Maestro8484/CyclopsGaze/docs/media/README.md

# Media

Photos and video of CyclopsGaze on the bench.

Drop image/video files here and reference them from the top-level [README.md](../../README.md)
and the docs.

**The hero shot is live** as of CG-S16: `CyclopsGaze-hero_photo.jpg`, a portrait close-up of the
`nordicBlue` eye with the SEN0626 camera mounted directly beneath it. The README renders it at a
constrained width because it is 1074x2114; a full-width portrait image is overwhelming on GitHub.
This replaces the never-existent `cyclopsgaze_tracking.jpg` that the README pointed at from
CG-S12 to CG-S16 and rendered as a broken image.

Video lives outside the repo on purpose. The 39-second demo clip and its Resolve project are in
`C:\Users\SuperMaster\Videos\CyclopsGaze\`, at 32 to 214 MB per render, which does not belong in
a git history everyone has to clone. Captions and platform copy for it are versioned here in
[VIDEO_CAPTIONS.md](VIDEO_CAPTIONS.md). If a clip is ever wanted in-repo, export a short
low-bitrate GIF or MP4 rather than committing a render.

Suggested shots still wanted:

- **Hero with a face in frame:** the assembled rig and a person, eye visibly looking toward them.
  The current hero is the rig alone.
- **Wiring:** a clear overhead of the wired breadboard/harness, matching the tables in
  [WIRING.md](../WIRING.md).
- **Serial:** a screenshot of the `[CG] faces=1 … -> tracking x=… y=…` serial output.
- **Dual-eye** (optional): both GC9A01A displays tracking together.
- **Detached camera module** (optional): the SEN0626 lens/ribbon separated from the Gravity board.

Keep files reasonably sized (long-edge ~1600 px for photos) so the repo stays lightweight. A short
tracking clip as a GIF or MP4 is welcome too.
