Maestro8484/CyclopsGaze/docs/SEN0626_PROTOCOL.md

# SEN0626 Protocol Reference

How CyclopsGaze talks to the DFRobot SEN0626 Gravity AI vision camera, and how its output
maps into the Useful Sensors Person Sensor struct. Driver source:
[`../src/sensors/SEN0626Sensor.cpp`](../src/sensors/SEN0626Sensor.cpp).

Primary vendor reference: DFRobot's `DFRobot_GestureFaceDetection` library and the SEN0626
wiki (`wiki.dfrobot.com/sen0626`). Everything below is cross-checked against that library and
confirmed on the bench except where marked assumed/unconfirmed.

## Transport

- **Protocol:** Modbus RTU over UART (not raw binary packets).
- **Device address:** `0x72`.
- **Baud:** `9600` factory default; `115200` also supported. The driver auto-detects: tries
  115200 then 9600, up to 3 full sweeps, after a 2s power-on settle (the sensor loads an AI
  model into RAM before it answers Modbus).
- **Wiring:** sensor on the Teensy's `Serial1`. Sensor TX → Teensy pin 0, sensor RX → Teensy
  pin 1. The breakout's I²C/UART DIP switch must be set to UART. (See [WIRING.md](WIRING.md).)

## Registers (FC04: read input registers)

| Reg | Meaning | Notes |
|----:|---|---|
| `0x00` | PID | expect `0x0272`, used for presence detection in `begin()` |
| `0x01` | VID | |
| `0x04` | face_number | 0–3, number of faces detected |
| `0x05` | face_x | face center X, `0–640` |
| `0x06` | face_y | face center Y, `0–480` (assumed VGA, unconfirmed) |
| `0x07` | face_score | `0–100` |

Registers `0x04`–`0x07` are contiguous and read in a single FC04 transaction (~22ms at 9600
baud). The driver self-throttles to `SAMPLE_TIME_MS = 150`.

## Key protocol facts (and how the driver handles them)

**No bounding box: the sensor reports a face center, not a box.** The register map exposes
only `face_number/x/y/score` (plus gesture/hand registers); there are no width/height/
box-edge registers. Center-only is the best available data, not a shortcut. The driver stores
the same center in both box edges:

```
box_left == box_right == cx      (so consumers recover the exact center, no edge drift)
box_top  == box_bottom == cy
```

Gotcha for consumers: any code that treats box **area** (`(right-left)*(bottom-top)`) as a
presence test will see area = 0 and silently discard every face. Area is a ranking key at
most, never a presence test. This is the exact bug the real IRIS swap hit, see
[IRIS_INTEGRATION.md](IRIS_INTEGRATION.md).

**No `is_facing` field.** The SEN0626 has no "looking at me" bit, so the driver hardcodes
`is_facing = 1`. Non-blocking for IRIS (its `psFacingRequired` defaults false). If ever
needed, derive facing from the sensor's head-pose/gesture registers.

**Confidence scale (CG-S12).** The driver emits the raw DFRobot score (0–100) as
`box_confidence`, and the consumer gates at `> 60` (DFRobot's own documented validity floor:
"a score ≥ 60 is considered valid"). Earlier revisions emitted `score*255/100` (0–255) and
gated at 152, same effective threshold, different scale. See [CHANGELOG](../CHANGELOG.md)
CG-S11/S12.

## Coordinate remap (sensor → 0–255 struct space)

```
NATIVE_W = 640
NATIVE_H = 480        # ASSUMED, confirm on bench via rawFaceY() (BENCH_PROTOCOL step 6)
cx = clamp(face_x, 0..640) * 255 / 640
cy = clamp(face_y, 0..480) * 255 / 480
box_confidence = clamp(face_score, 0..100)     # raw score, CG-S12
```

X and Y are each normalized over their own native span so a face at either frame edge drives
the gaze target to full deflection on that axis: correct edge-to-edge mapping despite the
4:3 vs 1:1 aspect mismatch. Intentional, not a bug.

## Drop-in contract

`SEN0626Sensor` exposes the byte-for-byte Useful Sensors `person_sensor_face_t` struct and a
method surface (`begin/isPresent/read/enableID/setMode/enableLED/numFacesFound/faceDetails/
timeSinceFaceDetectedMs`) matching the Person Sensor, so Person-Sensor consumers compile and
run unchanged. The `raw*()` accessors and `detectedBaud()` are additive calibration-only
extras (never called by consumers) and don't break the contract.

## Known unconfirmed items

- **`NATIVE_H` = 480 is assumed.** DFRobot documents the X range (0–640) but not Y. Confirm
  the true max `face_y` via the raw serial logging (`CG_CALIB_RAW`), see BENCH_PROTOCOL
  step 6.
- **`NATIVE_H` note above is the only unconfirmed protocol item.** The LED question below is
  settled.

## The onboard LEDs cannot be turned off in firmware

Asked again at CG-S17d and re-verified against DFRobot's current library header
(`DFRobot_GestureFaceDetection.h`) rather than the CG-S8 note. **This is the complete writable
register set on the device:**

| Holding register | Purpose |
|---|---|
| `0x00` | device address |
| `0x01` | baud rate |
| `0x02` | parity / stop bits |
| `0x03` | face detection threshold |
| `0x04` | face score threshold |
| `0x05` | gesture score threshold |

Read-only input registers are PID, VID, HW version, SW version, face number, face X, face Y,
face score, gesture type, gesture score. **There is no LED register, no brightness control and no
indicator enable anywhere in the device.** `SEN0626Sensor::enableLED(bool) {}` is therefore
correctly a no-op stub: it exists only to satisfy the Person Sensor method surface.

DFRobot document exactly two indicators
([wiki](https://wiki.dfrobot.com/SKU_SEN0626_Gesture_and_Face_Detection_Module)): a single white
**head-shoulder light**, lit steadily while a face is detected and extinguished when the person
leaves, and an **RGB gesture light** (blue Good, green OK, red Stop, yellow Victory, purple
Call-me). They document **no IR emitter and no night-vision illumination**. Absence from the
datasheet is not proof of absence, and the CG-S10 bench note in [WIRING.md](WIRING.md) refers to
an "IR-adjacent" component near the lens, so if this matters: point a phone camera at the board
in a dark room with no face in frame and look for a violet-white glow from anything that is not
one of those two LEDs.

To actually darken the board, in order of preference:

1. **Hide the main board.** CG-S10 bench-found the camera assembly attaches by ribbon and tape,
   not solder, and detection worked with only the camera plus ribbon in place. If the indicators
   are on the Gravity board rather than the camera sub-board, relocating the camera removes them
   from view with no modification. Confirm which board they sit on first, and re-verify detection
   afterwards, since CG-S10 left post-separation register behaviour open.
2. **Cover them.** Opaque tape or paint. Crude, immediate, reversible, and the right answer for a
   filming session.
3. **Desolder or lift them.** Permanent, guaranteed, and the usual risk to the board.

⚠ **Do not reach for register `0x04` for this.** Raising the sensor's internal face score
threshold would make the head-shoulder light fire less often, but it also stops the sensor
reporting sub-threshold faces at all, which fights the software gate in `config.h`
(`PS_CONF_GATE_DEFAULT`, 55 since CG-S17d) that needs to see scores in that band. It cannot
switch the light off for a genuinely detected face either.
