Maestro8484/CyclopsGaze/docs/ENGINEERING_LOG.md

# CyclopsGaze: Engineering Log

The full chronological engineering record: design decisions, the CG-S3 firmware audit,
external research, bench findings, status history. For focused reference, see the dedicated
docs: **[SEN0626_PROTOCOL.md](SEN0626_PROTOCOL.md)** (register/protocol),
**[BENCH_PROTOCOL.md](BENCH_PROTOCOL.md)** (first-flash procedure), **[WIRING.md](WIRING.md)**,
and **[IRIS_INTEGRATION.md](IRIS_INTEGRATION.md)**. Where this log and a dedicated doc or the
source disagree, the source and the newest CHANGELOG entry win. Parts of this log predate the
CG-S12 sync (raw-score gate + per-axis gain/bias).

## Session Notes

## Purpose & Deployment Framing (operator, 2026-07-04)

CyclopsGaze is a future-proofing / public-launch hardware change, not a fix for a current
problem. IRIS's live Useful Sensors Person Sensor (SEN-21231) is working fine right now.
Nothing about IRIS is broken and nothing here changes live IRIS. This project exists because
the Person Sensor is discontinued, so a drop-in replacement is needed (a) as insurance if the
live sensor ever dies, and (b) as the publicly-replicable gaze path for the IRIS launch
(buyers can't source a discontinued part).

Deployment posture: bench-only, on a spare non-installed Teensy 4.1. Don't pull the live
Person Sensor or touch installed IRIS hardware to test this. Flash + verify happens on the
standalone bench board once the T4.1 is connected. No timeline pressure; the live Person
Sensor stays the source of truth until CyclopsGaze is proven under load. Status stays
REPO-ONLY until then.

## SEN0626 Protocol (from DFRobot GitHub, 2026-06-24)

Source: https://github.com/DFRobot/DFRobot_GestureFaceDetection

Protocol: Modbus RTU over UART (not raw binary packets as originally anticipated in handoff)
Device address: 0x72 (from DFRobot example detectGesture.ino)
Default baud rate: 9600 (factory default; 115200 also supported via configUart)
PID register: input reg 0x00 = 0x0272 (used for presence detection in begin())

Registers (input, FC04):
  0x00 = PID         (expect 0x0272)
  0x01 = VID
  0x04 = face_number (0-3, number of faces detected)
  0x05 = face_x      (center X, 0-640)
  0x06 = face_y      (center Y, 0-480 assumed VGA, unconfirmed, verify on bench)
  0x07 = face_score  (0-100)

No bounding box: SEN0626 returns face center (X, Y), not a box. The DFRobot register map
(`DFRobot_GestureFaceDetection`) exposes only face_number, face_x, face_y, face_score, plus
gesture/hand registers. No width/height or box-edge registers to recover. Center-only is the
best available data, not a shortcut. Shim stores the same center in both edges
(box_left==box_right==cx, box_top==box_bottom==cy) so IRIS-side consumers recover the exact
target center even at frame edges. (Superseded the earlier cx±32 fake-box scheme: the
b84033d "center box" fix; a fake width biased the recovered center near the edges.)

No is_facing field: always set is_facing=1 in shim.
  Known gap: the real Person Sensor is_facing (is_looking_at) drives IRIS facing-gate logic.
  SEN0626 has no direct equivalent here; hardcoded true means "facing" is always asserted.
  Non-blocking for live IRIS because psFacingRequired defaults false since IRIS S153c. If ever
  re-enabled, derive facing from SEN0626 head-pose/gesture registers first (see
  IRIS_INTEGRATION.md §5).

Coordinate remap (matches SEN0626Sensor.cpp read()):
  NATIVE_W = 640
  NATIVE_H = 480 (assumed, confirm on bench via rawFaceY())
  cx = faceX * 255 / 640   (clamped faceX<=640)
  cy = faceY * 255 / 480   (clamped faceY<=480)
  box_left = box_right = cx
  box_top  = box_bottom = cy
  box_confidence = score * 255 / 100   (score clamped 0-100)

Modbus multi-register read: registers 0x04-0x07 read in one FC04 transaction (4 registers
contiguous), ~22ms per read at 9600 baud. SAMPLE_TIME_MS = 150.

Deviations from handoff:
1. Protocol is Modbus RTU, not raw streaming packets.
2. No bounding box, center stored in both box edges.
3. No is_facing field, hardcoded true.
4. Native Y resolution unconfirmed (480 assumed). Verify on bench.
5. SAMPLE_TIME_MS = 150ms (4 Modbus reads + inter-frame delay ~42ms; 150ms margin).

## Build

Target: Teensy 4.1. platformio.ini board = teensy41.
CG-S3 clean build (2026-07-04):
  Single-eye (default): SUCCESS ~5.0s. FLASH code 74076 / data 361032. RAM1 free 414880; RAM2
    free 511872. Only the benign C++17 `std::pair` argument-passing ABI note (present in the
    IRIS-verbatim EyeController; informational, not a warning).
  Dual-eye (`-DDUAL_EYE`): SUCCESS ~8.3s. FLASH code 74268. Builds clean too.

Drop-in contract (re-confirmed CG-S3): SEN0626Sensor's person_sensor_face_t matches IRIS
src/sensors/PersonSensor.h byte-for-byte; the Person Sensor method surface matches. The CG-S3
raw* calibration accessors are additive (IRIS never calls them) so the contract is intact.

---

## CG-S3 Audit: findings & verdicts (2026-07-04)

Every item from the peer review (07) and Opus handoff (10) §3 was traced against live code
and the IRIS reference. Verdicts below; "confirmed OK" items are recorded so they aren't
re-litigated next session.

### 3.1 Y-direction: verdict correct (not inverted). No code change.

The peer review (07 §Q4) hypothesised targetY needs negation. Rejected on the firmware-logic
side. CyclopsGaze main.cpp uses `targetX = -((cx/127.5)-1)`, `targetY = ((cy/127.5)-1)`. X
negated, Y not. IRIS's production main.cpp (`src/main.cpp:594-595`) uses the identical sign
convention against the identical (IRIS-verbatim) EyeController. IRIS tracking is
confirmed-correct in the field, so the mapping/render chain is correct; the peer review's
polar-map step for Y was the error, not the code.

Residual risk is sensor-side only: whether the SEN0626 reports face_y with 0=top-of-frame
(same as the Person Sensor) or 0=bottom (inverted). That's a hardware property, resolved on
the bench (protocol step 5). If vertical tracking is inverted there, the fix is a single sign
flip on targetY in main.cpp. But don't pre-negate now, that would break the match with the
known-good IRIS convention if the SEN0626 shares the PS orientation.

### 3.2 autoMove freeze: verdict fixed / complete. Verified.

The restructured loop evaluates the resume branch as an `else if` that runs whenever there's
no qualifying face, including when `sensor.read()` returns false (throttle window) or
returns true with a comms failure (readFaceData→0→num_faces 0). `timeSinceFaceDetectedMs()`
keeps climbing in every one of those paths, so after `FACE_LOST_MS` autoMove resumes and can
never stick off. Traced all paths (sensor absent, present-but-silent, throttled,
low-confidence). No stuck state. FACE_LOST_MS moved to a named config constant (was a bare
3000).

### 3.3 Center recovery: verdict exact, no drift. No change.

box_left==box_right==cx → IRIS's `left+(right-left)/2` = cx exactly; box_top==box_bottom==cy
→ `top+(bottom-top)/3` = cy exactly. CyclopsGaze main reads box_left/box_top directly, the
same value. No integer truncation drift at any value including 0 and 255 (0+0/2=0,
255+0/2=255). Center-only is the best available data (§Protocol: no box-dimension registers
exist).

### 3.4 Aspect-ratio mapping: verdict correct, not a bug. No change.

Independent per-axis normalisation (X over 640, Y over 480) maps each frame edge to full gaze
deflection on that axis. That's the desired edge-to-edge behavior: a face at the top edge
should drive the eye fully up regardless of the 4:3 vs 1:1 aspect. A single uniform scale
factor would under-drive the vertical axis and is the wrong fix. Matches how the Person Sensor
already normalises per-axis into 0-255. Documented inline in SEN0626Sensor.cpp read().

### 3.5 NATIVE_H = 480 unconfirmed: mitigation added.

Still assumed. Added raw register logging: shim now stores lastRawX/Y/Score and exposes
rawFaceX()/rawFaceY()/rawScore(); main.cpp prints them under `#define CG_CALIB_RAW 1`
(config.h, default ON). Bench step 6 reads the true max faceY off serial with no scope. If max
≈480 keep NATIVE_H=480; if ≈640 set 640.

### 3.6 Modbus timeout: verdict 300ms too long. Reduced to 100ms.

Normal round trip after flush ≈25ms (13.5ms wire for the 13-byte reply at 9600 + sensor
turnaround). Old 300ms meant a stalled/partial response froze renderFrame for up to 300ms.
New `MODBUS_RESP_TIMEOUT_MS = 100` keeps a ~4x margin against false timeouts while capping the
worst-case eye freeze at 100ms. Only bites on an actual comms glitch, at most once per 150ms
sample.

### 3.7 Confidence gate: divergence fixed, then re-calibrated against the vendor's own spec (CG-S5).

CyclopsGaze main previously tracked any detected face with no confidence gate. CG-S3 added
`PS_CONF_GATE` at 45, borrowed from IRIS's unrelated `psConfGate` constant (a different
sensor's calibration, not the SEN0626's). That mapped to an effective minimum SEN0626 score of
just ~19/100.

CG-S5: replaced with DFRobot's own documented threshold. The SEN0626 setup guide
(wiki.dfrobot.com/sen0626/docs/23024) states outright: "a score >=60 is considered valid", and
DFRobot's own sample code calls `gfd.setFaceDetectThres(60)`. 19/100 was roughly a third of
the vendor's own validity floor. Almost certainly accepting noisy/marginal detections, which
plausibly contributed to erratic tracking (see the lateral-tracking findings below).
`PS_CONF_GATE` is now 152 (`floor(60*255/100)-1`, so raw score 60 passes and 59 doesn't),
derived from spec, not guessed. Re-verify on the bench: does `gate=PASS` now correlate with
visibly stable tracking and `gate=REJECT` with faces you wouldn't trust anyway? If DFRobot's
own floor is still too strict or too loose for this specific unit, adjust from measured data,
not intuition.

Note the lost-timer follows raw detection (shim resets it on any face in the register, gated
or not), same as before. A persistent sub-gate face holds position rather than resuming
autoMove.

### External research: SEN0626 real-world specs, and vs. the Person Sensor (2026-07-06)

Bench testing (see below) turned up a narrow effective detection envelope and unstable
lateral tracking below a certain distance. Before writing more firmware, pulled the vendor's
own documentation and forum history to check whether these are known/expected
characteristics rather than bugs:

- Documented detection range: 0.5–3m (DFRobot wiki, `wiki.dfrobot.com/sen0626/` and the setup
  guide) for both gesture and face recognition. No separate, tighter face-specific number is
  given. 0.5m ≈ 19.7 inches. The operator's bench observation of tracking degrading below ~15
  inches is below this documented floor. That's out-of-spec operation, not a firmware bug.
  Bench step 9 (edge tracking) should be re-scoped to test at/above ~20 inches, not below.
- Field of view: 85° diagonal only. DFRobot doesn't publish separate horizontal/vertical FOV
  numbers. This is a real gap in their spec sheet (same gap already flagged for NATIVE_H:
  DFRobot documents the 0-640 X coordinate range but never states the Y range or the H/V FOV
  split). No authoritative number exists to compute an exact degrees-per-pixel value for
  either axis.
  - CyclopsGaze doesn't have a confirmed vendor explanation for the reported lateral
    (X-axis)-specific jitter at close range vs. clean vertical (Y-axis) tracking. Working
    hypothesis, not vendor-confirmed: natural head-tracking behavior turns the head in yaw
    (left/right) more than pitch (up/down) when following something laterally, and yaw
    rotation changes a frontal-trained face detector's visible landmark set more than pitch
    does. At close range, where angular resolution per unit of physical head movement is
    coarsest, this could plausibly show up as X-specific centroid noise. This is reasoned
    inference, not something the datasheet or forum discusses, flagged for the next session
    to test empirically (see archive/11_HANDOFF_FABLE_LATERAL_TRACKING.md).
- Confidence: DFRobot's own recommended validity floor is score >=60/100 (previous section,
  3.7), used to derive the CG-S5 `PS_CONF_GATE`.
- Known real-world failure modes (DFRobot forum, "SEN0626 Gesture and Face Detection Module
  failures," dfrobot.com/forum/topic/401101): dominant causes are power-supply instability
  ("unstable or low voltage can cause random resets, frozen output, or no detection at all")
  and wiring/comms issues, not a generally-faulty sensor. This matches this session's own
  bench finding exactly. A ~0.65V sag on the sensor's VCC (3.25V at the Teensy pin down to
  2.6V at the sensor, traced to a bad connector, not the regulator) was found and fixed before
  the confidence-gate work above. No third-party review reporting on tracking precision (as
  opposed to detection failures) was found.
- Person Sensor (SEN-21231) comparison, honest gap: no public datasheet with FOV-in-degrees
  or a documented minimum working distance was found for the Person Sensor (the
  SparkFun/DigiKey "datasheet" PDF is a one-page product blurb, not a technical spec sheet).
  A precise numeric side-by-side isn't possible. Qualitatively, though, this matters for the
  IRIS drop-in use case specifically: IRIS is a tabletop/desktop robot face meant to be looked
  at from close, conversational range, and its production history with the Person Sensor has
  never surfaced a "must stand back ~20 inches" complaint, while the SEN0626's documented
  0.5m floor sits right at or inside typical close conversational distance. If the operator's
  own IRIS interaction distance is regularly under ~20 inches, the SEN0626 is a real, sourced
  downgrade for that specific use case, not just a tuning gap. This should weigh on the
  IRIS_INTEGRATION.md gate decision, not just be tuned around.

### 3.8 mapRadius / tracking range: verdict correct, matches IRIS. Knob added.

nordicBlue polar.mapRadius = 240 (confirmed: `{240, polarAngle_240, ...}` in the eye
initializer; PolarParams default is also 240). r = (240*2 − 240*π/2)*0.75 = (480 −
376.99)*0.75 ≈ 77.3. At xTarget=±1: eyeNewX = 240 ∓ 77.3. This is the exact value the
production IRIS eyes use (identical EyeController + nordicBlue), so the range is field-proven.
The iris reaches its intended travel without the display cropping it. Added `GAZE_GAIN`
(config.h, default 1.0) multiplying targetX/targetY for bench range-tuning; setTargetPosition
clamps to the unit circle so gain >1 is safe.

### 3.9 Baud auto-detect robustness: hardened.

Old: 500ms settle then probe, per baud, no retry. The SEN0626 boots an AI model into RAM and
may not answer that early (IRIS waits ~2.5s for the Person Sensor's ML boot). New begin(): (1)
holds until `BOOT_SETTLE_MS`=2000ms from power-on before the first probe; (2) per-baud line
settle trimmed to 200ms (boot is now covered by the floor); (3) retries the full
115200→9600 sweep `BAUD_ATTEMPTS`=3 times, 300ms apart. Logs the winning baud + attempt
number. Worst case (sensor absent) ≈2s floor + ~2s of sweeps.

### 3.10 Other findings.

- Confidence gate was entirely absent from the consumer loop (fixed in 3.7).
- Magic numbers (3000 lost-timeout, implicit no-gain) lifted into named config constants
  (FACE_LOST_MS, GAZE_GAIN, PS_CONF_GATE) for bench tuning.
- `src/CyclopsGaze.ino` is a one-line dummy ("code is in main.cpp"); PlatformIO compiles it
  harmlessly alongside main.cpp. Left as-is.
- Modbus CRC, frame layout, flush-before-write, CRC-before-length validation: re-reviewed, all
  correct (peer review §5 stands).
- Multi-face selection: SEN0626 shim returns ≤1 face; the "largest face" loop in IRIS is
  harmless dead code against this shim.

---

## Flash & Verify: Bench Protocol (first flash)

REPO-ONLY. Run this once a spare T4.1 + SEN0626 + display(s) are wired per WIRING.md. An
operator new to PlatformIO can follow it top to bottom. Each step: action → expected serial →
pass/fail. Serial monitor at 115200.

Firmware version in repo: CG-S3 (bump before flashing if you change code).

### 1. USB enumeration

Action: connect the T4.1 by USB, then:
```
pio device list
```
Expect a line naming a Teensy port (e.g. `COM# ... USB Serial (Teensy)`).
PASS: a Teensy port appears. FAIL: none → check cable/board (CG-S2 saw only COM1 legacy +
COM4/5 Bluetooth, i.e. no Teensy).

### 2. Flash + boot message

Action:
```
pio run -e cyclopsgaze -t upload
pio device monitor -b 115200
```
Expect:
```
[CG] CyclopsGaze CG-S3
```
PASS: version line matches config.h FIRMWARE_VERSION. FAIL: no line / wrong version → confirm
upload target and monitor baud.

### 3. SEN0626 detect (baud + PID)

Expect within ~4s of boot one of:
```
[CG] SEN0626 found at 9600 (attempt 1)
[CG] SEN0626 found at 115200 (attempt 1)
```
Record which baud. FAIL:
```
[CG] SEN0626 NOT FOUND at 115200 or 9600 -- check wiring
```
→ check TX→pin0 / RX→pin1 cross, 3.3V, GND. (PID 0x0272 is validated internally; a wrong PID
reads as NOT FOUND.) Check the onboard DIP switch first. The SEN0626 breakout has a physical
I2C/UART mode switch; this firmware is UART-only. Confirmed on bench (2026-07-06): board
shipped/left in I2C mode produced NOT FOUND with correct wiring and correct code. Flipping
the switch to UART fixed it immediately, no code change. This is the most likely single cause
of a first-flash NOT FOUND and should be checked before re-wiring.

### 4. Face detect (serial format)

Action: sit ~1m in front of the sensor, facing it. Expect (CG_CALIB_RAW on):
```
[CG] faces=1 conf=NNN x=+0.NN y=+0.NN | rawX=NNN rawY=NNN rawScore=NN
```
Meaning: `conf` = box_confidence 0-255 (=score*255/100); `x`,`y` = target in [-1,+1] after
negation/gain; `rawX/rawY` = sensor center 0-640 / 0-480(?); `rawScore` = 0-100. PASS: faces=1
with plausible values when a face is present, faces logging stops when you leave. FAIL: never
faces=1 with a clear face → see step 7 (confidence).

### 5. Direction verification (ground truth from audit 3.1)

Move slowly and check the eye and the serial signs:

| Stimulus (your position vs sensor) | Expected `x`/`y` sign | Expected eye |
|---|---|---|
| Face to camera's RIGHT | x more negative | eye looks RIGHT |
| Face to camera's LEFT  | x more positive | eye looks LEFT |
| Face toward TOP of frame | y toward −1 | eye looks UP |
| Face toward BOTTOM of frame | y toward +1 | eye looks DOWN |
| Face centered | x≈0 y≈0 | eye straight ahead |

PASS: eye follows you in all four directions. Horizontal is verified-correct by design
(matches IRIS). If vertical is inverted (face up → eye down): that's the SEN0626 Y-axis
orientation differing from the Person Sensor. Flip the sign of `targetY` in main.cpp
(`((cy/127.5f)-1.0f)` → `-((cy/127.5f)-1.0f)`), reflash, and note it here. Don't touch targetX.

### 6. NATIVE_H calibration (480 vs 640)

Action: keep a face in frame; move to the very TOP then very BOTTOM of the field, watching
`rawY`. Note the maximum rawY you can produce at the bottom edge.
- Max rawY ≈ 480 → NATIVE_H=480 is correct, leave it.
- Max rawY ≈ 640 → set `NATIVE_H = 640` in SEN0626Sensor.h, reflash. (At present, Y > ~480
  clamps and the eye saturates vertically before the true edge.)
Record the observed max here. Also sanity-check rawX maxes near 640.

### 7. Confidence calibration

Action: at ~1m frontal, read the `conf` field (and rawScore).
Expected (CG-S5): a clear frontal face should comfortably clear conf > 152 (raw score ≥60,
DFRobot's own documented validity floor, ENGINEERING_LOG.md "External research").
- If a clear face reads conf ≤152 / it won't track: this means DFRobot's own recommended
  floor is too strict for this specific unit. Lower `PS_CONF_GATE` in config.h incrementally,
  reflash, and record the value that stabilizes tracking without letting empty-frame noise
  through.
- If noise/empty frames produce faces=1 even at 152: raise PS_CONF_GATE further.

### 7b. Distance floor + lateral (X-axis) tracking (CG-S5, bench-observed 2026-07-06)

DFRobot's own documented detection range is 0.5–3m (~19.7in – ~9.8ft) for both gesture and
face recognition (ENGINEERING_LOG.md "External research"). Below ~20 inches is out-of-spec
operation. Instability there is expected, not a firmware bug. Test at/above 20 inches, not
below.

A power issue was also found and fixed this session (2.6V measured at the sensor's VCC vs.
3.25V at the Teensy's own 3.3V pin, traced to a bad connector in the VCC run, not the
Teensy's regulator; reseating/direct-wiring fixed it). If you haven't already, confirm the
sensor's VCC reads ~3.2-3.3V before re-running this step, since undervolting an
active-inference sensor can independently produce exactly this kind of instability.

Action: with VCC confirmed healthy and PS_CONF_GATE=152, stand at ~24-36 inches (safely inside
the documented range) and move laterally (left/right) while keeping the same distance. Watch
`rawX` and the eye's horizontal tracking specifically. The operator reported clean vertical
(Y) tracking but unstable lateral (X) tracking, worse the closer they stood.
- If `rawX` is steady while you hold still and only moves when you actually move: X tracking
  is fine at this distance, the problem was distance-related (floor violation) and/or the
  now-fixed power issue, not a firmware/mapping bug.
- If `rawX` still jitters rapidly while you hold still at 24-36": that's a genuine sensor-side
  X-axis noise issue independent of distance and power. See
  archive/11_HANDOFF_FABLE_LATERAL_TRACKING.md for the investigation plan (a smoothing/
  low-pass filter on targetX, modeled on IRIS's own panServo `filteredPan` alpha=0.15 pattern,
  is the leading candidate fix if this turns out to be sensor noise rather than a mapping bug).

### 8. AutoMove resume (lost timeout)

Action: with the eye tracking you, leave the frame entirely; start a timer. Expect: ~3s
(FACE_LOST_MS) after your last detection the eye stops holding and begins idle wander (random
saccades). Return to frame → it re-locks. PASS: wander resumes ≈3s after you leave and never
earlier while you're tracked. FAIL: eye freezes forever → regression in the loop's else-if
(audit 3.2).

### 9. Edge tracking / flaky comms

Action: (a) move to the extreme corners of the field and hold. Expect the eye to reach its
travel limit and stay smooth. No freeze, no snap-back, no drift while you hold. (b) Briefly
interrupt the sensor TX wire. Expect no crash; the eye holds last position, then wanders after
~3s, and re-locks when comms return. PASS: both. FAIL: freeze/crash → note timeout (audit 3.6)
or wiring.

### 10. Dual-eye addendum (only if built with `#define DUAL_EYE`)

Action: wire the second display (WIRING.md dual-eye table: CS9/DC8/RST6, shared SCK13/MOSI11),
uncomment `#define DUAL_EYE`, reflash. Expect: both displays show an eye at boot; both track
the same face together; neither is blank or frozen. PASS: two coordinated eyes. FAIL: second
display blank → check CS9/DC8/RST6 wiring and that SCK/MOSI are shared to pins 13/11. Note:
per-eye refresh is ~half single-eye (shared bus), expected, not a fault.

---

## Issues Found

Resolved this session (2026-07-06), T4.1 connected on COM6:
- SEN0626 initially NOT FOUND. Root cause was the sensor's onboard I2C/UART DIP switch left
  in I2C mode (this firmware is UART-only). Fixed by flipping the switch; documented in
  WIRING.md and bench step 3.
- SEN0626 VCC measured 2.6V vs 3.25V at the Teensy's own 3.3V pin. A bad connector in the
  VCC run (not the Teensy regulator, which tested healthy). Fixed by reseating/direct-wiring.
  Undervolting an active-inference sensor is a documented SEN0626 forum failure mode
  (ENGINEERING_LOG.md "External research") and plausibly contributed to the narrow detection
  envelope reported below.
- Confidence gate was tuned against IRIS's own unrelated constant (45), not the SEN0626's
  actual behavior. Replaced with DFRobot's documented floor (score >=60 → PS_CONF_GATE=152,
  CG-S5, audit 3.7).

Resolved 2026-07-07 (CG-S6/S7/S8 bench pass, operator live on COM6):
- Lateral (X) tracking: root cause was a mirror, not noise. Double X-flip (main.cpp negation
  + EyeController eyeIndex==0 flip on a single eye). Fixed CG-S6 by removing the main.cpp
  negation. Bench-VERIFIED correct L/R.
- Gaze range too small: GAZE_GAIN 1.0 → 1.7 (CG-S7), derived from measured rawX span 151-427.
  Bench-VERIFIED.
- Upward-gaze bias / eye pinned up: Y_CENTER=33 (CG-S8). Sensor mounts below the eye so
  eye-level images near frame top; old code used 127.5 as neutral. Bench-VERIFIED neutral now
  ≈0.

Open (non-blocking for IRIS):
- Upward-gaze travel is hardware-limited (~9 rawY counts above neutral) because the sensor
  sits below the eye. Fix is physical (tilt/lower sensor), not code.
- NATIVE_H (480 vs 640): DFRobot's register doc labels face_y "0-640" but the extraction was
  self-inconsistent; not trusted, NATIVE_H left at 480. Confirm via peak rawY on a deliberate
  look-down test if it ever matters.
- LED: no Modbus register exists (confirmed vs DFRobot wiki + library). Cannot disable in
  firmware, physical cover only. enableLED() stays a no-op stub.

## Status: VERIFIED (2026-07-07), ready for IRIS integration

Tracking is bench-verified end-to-end (COM6, operator live). CyclopsGaze is cleared as a
drop-in Person Sensor (SEN-21231) replacement. Unblocks IRIS_INTEGRATION.md.

- [x] Steps 1-3: enumerate, flash, boot + SEN0626 baud, done.
- [x] Step 4: face-detect serial line confirmed (gate=PASS, rawX/rawY logging).
- [x] Step 5: L/R fixed (CG-S6 mirror fix) and U/D confirmed after Y_CENTER.
- [x] Step 7: PS_CONF_GATE=152 confirmed passing on live bench scores (60-74).
- [x] Step 7b: lateral tracking resolved. Was a mirror bug, not noise/distance.

Deploy-time (not blockers):
- [ ] Upward gaze: tilt/lower sensor for more above-eye-level headroom (physical).
- [ ] Set CG_CALIB_RAW to 0 for quiet serial once done bench-logging.
- [ ] Step 6: confirm NATIVE_H 480 vs 640 only if Y precision ever matters.

## IRIS integration (CG-S9, 2026-07-07)

Code-reviewed both IRIS consumers of the dead Person Sensor and produced drop-ins. Details in
IRIS_INTEGRATION.md + integration/README.md. Summary:
- T4.1 eyes: `src/sensors/SEN0626Sensor.{h,cpp}` is the class drop-in; method surface + struct
  verified against live IRIS. `isPresent()` now lazy-begins so IRIS's probe loop needs no
  `begin()` edit.
- T4.0 servo: new `integration/servo_teensy40_base_mount/person_sensor.{h,cpp}` reimplements
  the servo's `PersonResult` interface on SEN0626 (Serial1).
- Two operator decisions flagged (not auto-applied): confidence scale (IRIS psConfGate capped
  0-100 vs shim 0-255) and eyes direction/psYBias. Don't copy CyclopsGaze's CG-S6/CG-S8
  tracking edits into IRIS.
- IRIS adapters are REPO-ONLY until an IRIS deploy session flashes/benches them.

## CG-S10 (2026-07-15): camera module is physically separable from the main PCB

Bench finding, not yet firmware/software related. A mechanical discovery. The SEN0626's
camera lens/sensor assembly attaches to the Gravity breakout via a ribbon cable and
double-sided tape, not a fixed/soldered connection.

Bench-tested with the camera sensor disconnected from the main SEN0626 board (the board's
head-shoulder indicator LED, gesture RGB LED, and any IR-adjacent component were not
present/connected). Face identification and tracking output functioned correctly with only
the camera sensor + ribbon in place.

Confirmed not required for face detect/track:
- Head-shoulder indicator LED (white)
- Gesture indicator LED (RGB)
- Any IR-associated component mounted alongside the lens on the main board

Why this matters: the full Gravity board footprint has been the physical objection to SEN0626
as a Person Sensor (SEN-21231) drop-in. The original is tiny, the Gravity breakout is not. If
the camera + ribbon alone is sufficient, SEN0626 can be mounted in a footprint closer to the
original sensor's, without carrying the rest of the board. This strengthens both of
CyclopsGaze's reasons for existing (§ Purpose above): insurance if IRIS's live Person Sensor
ever fails, and the public-launch replicability recipe (IRIS_INTEGRATION.md §8).

Open before calling this VERIFIED: confirm the detached camera sensor still reports through
the same I2C/UART register set, same device address, same baud rate once separated from the
main board. If any board-side circuitry (beyond the LEDs/IR components already ruled out
above) was doing signal conditioning for the camera link, register reads could differ once
relocated. Test raw register output side-by-side (attached vs. detached) before finalizing the
swap, same protocol as the existing `CG_CALIB_RAW` bench logging (§ SEN0626 Protocol above).

Status: REPO-ONLY bench finding. Not yet flashed or integrated into firmware.

## CG-S13 (2026-07-21): sync pass #2 from live IRIS, transport knob + PS_CFG live tuning

Session purpose was "bring IRIS's polished firmware back". The first job was establishing what
had actually drifted. Everything below was read from the live IRIS repo and the running Pi4
that day, not recalled.

### What was NOT drifted (measured, so it isn't re-litigated next session)

- `diff` of `SEN0626Sensor.{h,cpp}` IRIS-vs-CyclopsGaze: comment text only, zero code
  difference. The driver hadn't drifted at all.
- IRIS's gaze code is frozen at S212c. Its last touch of `src/main.cpp`/`src/config.h` is S213
  (2026-07-18), which changed only `PROTOCOL_VERSION`. CG-S12 had already synced the S212c
  model. So there was no un-synced IRIS code change to bring back. The premise needed
  correcting before any edit was made.

### What HAD drifted (the actual transfer)

1. The UART is not the same port. Live IRIS runs the sensor on `Serial4` (RX 16 / TX 17), not
   `Serial1`. Pin 0 is IRIS's left-eye CS (IRIS `src/config.h` §"Gaze sensor transport
   (S212)"; Serial2/Serial8 also ruled out there against the mouth display's DC/MOSI). Two
   CyclopsGaze docs (`IRIS_INTEGRATION.md`, `integration/README.md`) asserted IRIS used
   `Serial1`. Both were wrong and are corrected. The port is now a config knob,
   `SEN0626_SERIAL` (adopting IRIS's own mechanism), default `Serial1` for this bench rig.
2. `PS_CFG:` runtime tuning ported (IRIS S141 + S212c), the real polish. Gate, per-axis
   gain/bias, lost-timeout, facing and LED are now runtime `ps*` variables retunable over the
   USB serial link with no reflash. Parser, key set, `[DBG] PS_CFG KEY=value` ack wording and
   the S212c false-ack guard are IRIS's verbatim, and the runtime variable names match IRIS's
   exactly, so the two `main.cpp` files stay diffable. This directly attacks the standing #1
   priority: the CG-S12 re-bench no longer costs an edit-reflash cycle per tuning step.
   - One CyclopsGaze-only addition: `PS_CFG?`, a one-line readback. Justified: IRIS reads
     live values back from the Pi4's `ps_config.json` via the WebUI; a standalone board has no
     store, so without it there's no way to read state mid-bench. Deliberately not in the ack
     shape.
   - Values are RAM-only here and revert on reset (no `ps_config.json` equivalent).
3. Facing gate added for parity (`psFacingRequired`, default false). Inert on SEN0626. The
   shim hardcodes `is_facing=1`, but it closes a surface gap against IRIS.
4. Gaze math now IRIS's verbatim expression (`box_left + (box_right-box_left)/2`, and the `/3`
   "aim a third down the box" term for Y) instead of reading `box_left`/`box_top` directly.
   Zero behavior change. The shim's box is center-only so both delta terms are 0 and it
   collapses to the exact center. Established by algebra, not bench. Done for diffability and
   so a real bounding-box sensor would work unmodified.

### IRIS-vs-CyclopsGaze value diff (open, owed a behavioral comparison)

Observed on the running system 2026-07-21 (Teensy acks on the wire at 09:29, firmware S213):
`CONF=25 FACING=0 LOST_MS=8500 Y_BIAS=0.0 X_GAIN=1.0 Y_GAIN=1.0 X_BIAS=0.0`. IRIS is tracking
with these (79 `FACE:1` acquisitions that day, latest 13:54).

| Knob | CyclopsGaze | Live IRIS |
|---|---|---|
| `X_GAIN` / `Y_GAIN` | 1.7 / 1.7 | 1.0 / 1.0 |
| `X_BIAS` / `Y_BIAS` | 0.0 / 1.26 | 0.0 / 0.0 |
| `CONF` | 60 | 25 |
| `LOST_MS` | 3000 | 8500 |

The IRIS values are not tuned values. `/home/pi/ps_config.json` is dated 2026-07-15 (before
the S212 swap, 07-16) and contains no `X_GAIN`/`Y_GAIN`/`X_BIAS` keys at all, so all three
fall back to firmware compile-time defaults. `CONF=25` is a Person-Sensor-era number on the
old 0–255 scale (~10%) now applied to the SEN0626's raw 0–100 score, far below DFRobot's
documented 60 floor; IRIS's own S212 source comment flags raising it as an unmade operator
decision, and it's still 25. CyclopsGaze's numbers, by contrast, are measured (CG-S7 gain from
`rawX` span 151–427; CG-S8 `Y_BIAS` from measured eye-level `cy≈33`).

Operator decision (this session): keep CyclopsGaze's measured defaults. Adopting IRIS's would
trade measured data for unmeasured, and gain/bias are mount-geometry-specific anyway.

Open / owed: run both value sets head-to-head on one rig and record which actually gazes
better. Neither is established as better today; only CyclopsGaze's has bench data behind it.
Both sets are now `PS_CFG:` one-liners, so this is a cheap test, do it during the CG-S12
re-bench.

### Status

REPO-ONLY. Both builds clean on Teensy 4.1: single-eye (FLASH code 82876, RAM1 free 413824)
and `-DDUAL_EYE` (code 83068). Nothing was flashed and nothing was observed running: `pio
device list` showed only COM1 (legacy) and COM4/COM5 (Bluetooth). No Teensy enumerated on
SuperMaster this session. The PS_CFG parser, the facing gate and the IRIS-form gaze math are
unverified on hardware, on top of CG-S12's still-unverified raw-score gate and gain/bias.

Checks that would confirm, in order, on the next flash with a spare SEN0626 + T4.1:
1. Boot line reads `[CG] CyclopsGaze CG-S13`.
2. `PS_CFG?` returns the config.h defaults; `PS_CFG:X_GAIN=2.5` acks and visibly widens
   travel; a typo'd key answers `UNKNOWN key` and changes nothing.
3. Full docs/BENCH_PROTOCOL.md re-run (steps 5–7 re-confirm CG-S12).
4. The IRIS-vs-CyclopsGaze value comparison above.

## CG-S14 (2026-07-21): ESP32-S3 migration feasibility (docs only)

Exploratory only. No source touched, `FIRMWARE_VERSION` unchanged at CG-S13. The full study is
**[ESP32_S3_MIGRATION.md](ESP32_S3_MIGRATION.md)**; recorded here are the findings that are facts
about *this* codebase and outlive the migration question either way.

### The render engine is not the Teensy-coupled part, the display driver is

Expectation going in was that 19k lines of TeensyEyes would be the blocker. Read against live
source, it is not. `EyeController.h` was read in full (600 lines): pure C++ plus Arduino
`millis()`/`random()`, no Teensy API anywhere. `eyes.h` is the same but for an ARM-only `-Wpsabi`
pragma at line 5. The ~18k lines of LUT data are portable as written: `PROGMEM` is a no-op on
both Teensy 4 and ESP32, and the code dereferences the tables directly rather than through
`pgm_read_byte`, so the same source works on both.

What *is* welded to the Teensy is `GC9A01A_t3n`. Its `library.json` advertises
`"platforms": "*"`. That manifest is wrong. The header is gated on `__IMXRT1062__` /
`__IMXRT1052__` / `KINETISK`, includes Teensy's `DMAChannel.h`, and manipulates `IMXRT_LPSPI_t`
and `KINETISK_SPI_t` peripheral register structs directly (29 sites in the `.cpp`). It cannot be
ported, only replaced.

That the swap is cheap is a property the repo already has and should keep: `displays/Display.h`
is a 31-line CRTP base with exactly five methods (`drawPixel`, `drawFastVLine`, `drawText`,
`update`, `isAvailable`), and `EyeController` is templated on it. Any backend that implements
those five is a drop-in selected in `config.h`. Worth protecting in future edits, it is what
makes the render engine portable in practice and not just in principle.

One dependency hides in that seam: `GC9A01A_Display.cpp:22` calls `updateChangedAreasOnly(true)`.
Any replacement backend needs an equivalent or it pushes the full 115,200-byte buffer every
frame, a hard ~21 FPS ceiling at 20 MHz SPI from bus time alone.

### Latent bug in the driver, exposed by the port question (applies to the Teensy build too)

[`SEN0626Sensor.cpp:84`](../src/sensors/SEN0626Sensor.cpp#L84) waits out the sensor's AI-model
boot with `while (millis() < BOOT_SETTLE_MS) {}`, a 2-second bare spin with no yield. On the
bare-metal Teensy this is harmless and has never caused a problem. Under FreeRTOS on an ESP32-S3
it starves the idle task and risks a task-watchdog reset. The fix (a `delay()`-based wait) is
strictly correct on both platforms and costs nothing on Teensy.

⚠ **IRIS runs this same driver on its own T4.1.** Harmless there today, same shape. Flagged for
an IRIS session; not edited from here (IRIS is read-only from this repo).

### The Teensy already runs the tables from flash. A premise was wrong.

Recorded because it reversed this session's own conclusion. An earlier draft of
ESP32_S3_MIGRATION.md asserted the lookup tables must be copied into internal SRAM on an S3,
and derived a hard "only one eye design fits" limit from it. The premise, that the tables are
RAM-resident today, was never checked. Checking it disproved it.

`arm-none-eabi-size -A .pio/build/cyclopsgaze/firmware.elf`:

```
.text.progmem     352136   1610622324     <- 0x60002574, external QSPI flash
.data               9920    536870912     <- 0x20000000, DTCM
.bss                2240    536880832     <- DTCM
.bss.dma           12416    538968064     <- 0x20200000, OCRAM
```

The bench-VERIFIED Teensy 4.1 build holds **only 12 KB of variables in RAM** and streams all
352 KB of tables out of external QSPI flash through the FlexSPI cache, at random, five times
per pixel. That is precisely the access pattern that was being treated as the S3's
disqualifying risk. It is the normal operating mode of the board this project already trusts.

Durable consequences: tables in flash is the baseline for any port, not a compromise. SRAM
residency is an optimization the S3 has available and the Teensy does not. Eye-design count is
bounded by flash, not RAM. PSRAM is not needed, since two 115,200-byte framebuffers fit inside
512 KB of SRAM.

### Measured render-loop cost: the numbers, so they are not re-derived

Produced by replaying `renderEye()`'s exact address arithmetic
([EyeController.h:326-445](../src/eyes/EyeController.h#L326)) over the real tables on the host,
centred gaze, steady state. Simulation of the real pattern over real data. Not hardware.

- **43,312 pixels per frame** (the loop covers the eyelid aperture, not all 57,600).
- **214,492 table reads per frame**, 4.95 per pixel.
- `drawAll` costs the *same* table reads as steady state; the extra area is flat eyelid fill.

| Table | Size | Unique bytes/frame | Fetched (32 B lines) | Waste |
|---|---|---|---|---|
| `disp_240_125` | 14,400 | 11,909 | 13,504 | 1.13x |
| `polarAngle_240` | 57,600 | 11,757 | 37,184 | 3.16x |
| `polarDist_240_125_69_0` | 57,600 | 11,559 | 35,552 | 3.08x |
| `eyeSclera` | 90,000 | 41,508 | 60,736 | 1.46x |
| `eyeIris` | 131,072 | 25,800 | 83,200 | 3.22x |
| **total** | **350,672** | **102,533** | **230,176** | **2.24x** |

The polar tables and iris texture are indexed with a 240-byte stride, so most of each fetched
line is discarded. Per frame the render needs 100 KB and hauls 230 KB. Across 13 gaze
positions x 3 pupil sizes, 79% of all table bytes are touched, so there is no small hot subset.

Cache simulation (LRU, set-associative, cold start): 64 KB/32 B/8-way misses 4.94%,
32 KB/32 B/8-way 8.57%, 16 KB/32 B/4-way 26.02%. **64-byte lines are worse than 32-byte**
(21.82% vs 8.57% at 32 KB) because the striding wastes the extra bytes and halves effective
capacity. Line size is a build setting on the S3 and the instinctive "bigger is better" choice
is the wrong one here. The 16 KB row is why RP2350/Pico 2 was rejected despite costing $5.

Plus 115,200 B of framebuffer per eye (`useFrameBuffer=true`). Table sizes are consistent with
the CG-S2 build report's flash-data figure.

**Still unmeasured, and it is the gap that matters: nobody has ever recorded this project's
frame rate on any board.** `SHOW_FPS` sits commented out at `src/displays/Display.h:5`. Until
that number exists there is no baseline for any port to be judged against.

### BOM and board selection (prices fetched from vendor pages 2026-07-21, not recalled)

Full sourced list is now **[BOM.md](BOM.md)**. Findings worth keeping here:

Board choice is **ESP32-S3-DevKitC-1-N8R8, $15.00, 704 in stock at DigiKey**, selected on
cache size (the deciding spec per the table above). Order the plain `-1`; the `-1U` variant
showed zero stock and an 8 week lead, and the no-PSRAM `-N8` is discontinued so `-N8R8` is the
part whether or not the PSRAM is used. Rejected Raspberry Pi Pico 2 despite $5 and superb
availability: RP2350's XIP cache is 16 KB, the 26%-miss row, and 350 KB of tables plus two
framebuffers is 580 KB against 520 KB so SRAM cannot rescue it. Rejected ESP32-P4 (768 KB
SRAM, 400 MHz, which would erase every constraint) on toolchain maturity, since Arduino
support was still beta as of April 2026 with no official PlatformIO support, and an unofficial
toolchain fork is a worse tax than tight memory for a project whose deliverable is public
replicability. Also withdrew an earlier same-session recommendation of the Waveshare DualEye
integrated board: bundling two panels into the board price only wins if you do not already own
panels.

Two objections recorded as *checked*, one rejected and one upheld:
- **Rejected:** "the AI camera dominates the BOM, so the MCU is the wrong lever." At $14.90
  the SEN0626 does not dominate, and the Teensy at $31.50 was the largest line item.
- **Upheld, and it emerged only after pricing domestic sources:** once you source
  domestically, **the display dominates, not the MCU.** Two Adafruit 6178 panels are $35.00
  against $29.90 for board plus camera. Display sourcing is a bigger cost lever than the
  entire MCU decision, and the MCU swap saves $16.50 against a Teensy 4.1, roughly a quarter
  of a two-eye build rather than half.

Sourcing note for anyone republishing the BOM: **DigiKey cannot complete the cart.** Their
only 1.28in round GC9A01A listing is the Adafruit 6178 (`1528-6178-ND`), marked obsolete and
unstocked, so a domestic build is two vendors. Also note DigiKey's "obsolete" flag means "we
stopped carrying it," not "it is discontinued": the 6178 is marked obsolete there while
Adafruit have it in stock, same as the `-N8` devkit while `-N8R8` shows 704 units. Check the
manufacturer before believing a distributor's end-of-life flag.

### Status

REPO-ONLY, docs only. Nothing was built for ESP32-S3, nothing flashed, no frame rate observed.
The standing #1 priority is unchanged and unaffected: re-run docs/BENCH_PROTOCOL.md on the Teensy
to close out CG-S12/CG-S13's unverified gate, gain/bias, PS_CFG parser and facing gate.

## CG-S16 (2026-07-25): demo-video captions, and a bench session missing from the log

Media work, no source touched, `FIRMWARE_VERSION` unchanged at CG-S15. Caption drafts, the
shipped cue list and the platform copy live in **[media/VIDEO_CAPTIONS.md](media/VIDEO_CAPTIONS.md)**.
Recorded here are the two findings that outlive the video.

### Resolved: CG-S15 was flashed, and the eye rotation was rejected on taste

The discrepancy described below was opened by this session and closed by the operator in the
same session. Their words, which outrank every inference here: they flashed the firmware
carrying the serial eye-set change, and they then reverted `eyeDefinitions` to a single set by
hand because cycling eye designs looks wrong in a face-tracking demo. Also: **ChatGPT/Codex
sessions on this repo are read-only**, so the uncommitted edit was the operator's, not an
agent's.

What that establishes, and what it does not:

- **CG-S15 is DEPLOYED.** That binary necessarily carries CG-S12's raw-score gate and per-axis
  gain/bias and CG-S13's PS_CFG parser, since they are all in the same source lineage. The
  long-standing "CG-S12 has never run on hardware" caveat is retired.
- Tracking behaviour was observed by the operator while filming. So the gate at 60 on DFRobot's
  raw 0-100 scale does admit real faces, and the gain/bias produce usable travel in the right
  direction. Those two CG-S12 changes are behaviourally sound.
- The rotation mechanism ran on hardware and was rejected as a presentation choice, not as a
  fault. Worth separating: a feature can work and still be wrong for the demo.
- **Not established, and still owed:** `PS_CFG:` parse/ack/readback, the facing gate,
  `LOST_MS`/autoMove resume, NATIVE_H 480-vs-640, dual-eye (step 10) and frame rate (step 11).
  None of these are visible in a video. What would confirm each is unchanged in
  BENCH_PROTOCOL.md.

The rest of this section is kept as written because the reasoning is still the right default:
absent the operator's statement, a video file is not evidence of a firmware version.

### The footage documents a bench state the repo does not

`C:\Users\SuperMaster\Videos\CyclopsGaze\` holds a 38.702 s clip dated 2026-07-24 (measured with
`ffprobe`; 1920x1080, ~30 fps, AAC) plus stabilized, reframed and already-captioned renders. Frames
sampled out of it show the rig powered and rendering: one round GC9A01A running `nordicBlue`, the
SEN0626 mounted directly below the display on a purple stand, a Teensy on a breadboard beside it,
autonomous blinks and pupil dilation, and the iris staying turned toward the operator through a
full handheld orbit.

CG-S15 (2026-07-21) records REPO-ONLY, "nothing was flashed and no eye was observed changing."
The clip postdates that by three days. Separately, the working copy of `src/config.h` carries an
uncommitted edit taking `eyeDefinitions` from `<1,2>` back to `<1,1>` with `{hazel::eye}`
commented out, i.e. somebody deliberately reduced the build to a single eye set, which is a
choice you make at a bench and not at a keyboard.

**Deliberately not upgraded to DEPLOYED or VERIFIED.** What was observed this session is a video
file, not a boot line and not a serial log. A clip cannot establish which firmware is on the
board, and CG-S12's raw-score gate, CG-S13's PS_CFG parser and facing gate are exactly the things
a video cannot show. The status words mean flashed and flashed-plus-observed, and neither was
observed here.

Owed, and cheap: the operator states which firmware is on the board and whether that session
exercised the gate / gain / bias / PS_CFG path. If it did, CG-S15's status line and the CG-S12
re-bench debt both change materially, and the #1 priority may be partly discharged already
without anyone having written it down.

### Captions had to be written against the footage, not against the firmware docs

Worth keeping because it will recur every time this project produces media. Two caption claims
that the repo's own documentation would have supported were false about the clip:

1. CG-S15 added a second eye set and 20-second rotation, and the README documents it. The clip
   shows `nordicBlue` for all 39 s, consistent with the uncommitted single-set `config.h`. A
   caption asserting a rotating look would have been contradicted on screen.
2. Idle-wander-then-relock (BENCH_PROTOCOL step 8) is real firmware behavior, but the operator
   never leaves frame in this clip, so a caption timed over the footage would read as a promise
   the viewer never sees paid. Shipped as a capability statement instead.

Also caught while pricing a caption: README's intro says "around $47 in parts for a single
tracking eye," which is [BOM.md](BOM.md)'s ESP32-S3 row for a board nothing has ever been built
on. The rig on screen is the T4.1 build at $63.90, and README § Path A already quotes ~$64. Not
corrected, since the $47 line is arguably about the cheapest route rather than the demo rig, but
any public copy should quote $64 for anything showing this hardware.

### Eye artwork: what a disabled eye actually costs, measured

The eye catalogue went from 2 designs to 10 this session. The design question was whether
bundling artwork nobody has enabled is expensive. It is not, and the number is worth keeping so
nobody re-derives it.

Controlled A/B, one variable, everything else identical:

| Build | FLASH code | FLASH data |
|---|---|---|
| CG-S13 baseline, before any second eye existed | 82,876 | 362,056 |
| CG-S15, `nordicBlue` + `hazel` both enabled | 119,468 | 646,808 |
| `hazel.h` included, its row commented out | 83,836 | **362,056** |
| `hazel.h` also commented out | 83,836 | **362,056** |
| `bigBlue` + `skull` additionally enabled (test, reverted) | 83,964 | 909,776 |

The last two rows are the finding: including an eye header without referencing it costs
**nothing at all**, not one byte, and both figures land exactly on the pre-hazel baseline. The
Teensy Arduino builder passes `-fdata-sections` and `-Wl,--gc-sections`
(`~/.platformio/platforms/teensy/builder/frameworks/arduino.py:103,121`), so unreferenced const
tables never reach the binary. Consequences: bundling 8 eye headers and 10 table `.cpp` files
added ~3.4 MB of repo and 0 bytes of firmware; upstream's advice to comment the `#include` as
well is belt-and-braces on this toolchain rather than load-bearing; and the failure mode that
actually matters is the reverse one, a row uncommented without its include, which is a compile
error naming the eye.

Two constraints were checked against source rather than believed:

- **`mapRadius` is not a real restriction.** CG-S15 documented "all sets must share
  `polar.mapRadius`" as a live hazard. All 23 upstream eyes set it positionally to 240, verified
  by extracting the polar initializer from every header. Nothing in the catalogue can violate it.
  The warning stays for anyone *authoring* an eye, but it cannot be tripped by selecting one.
- **Eyeball `radius` may differ between sets.** 120, 125 and 130 are all bundled.
  `EyeController` reads `definition->radius` per frame (`EyeController.h:233`) and
  `updateDefinition()` caches nothing derived from it, so a swap picks it up immediately.

### A C++17 deduction trap that would have shipped broken

Removing the hand-maintained array count looked like a job for class template argument
deduction: `std::array eyeDefinitions{ std::array{nordicBlue::eye} }`. It does not work, and it
fails in the worst possible direction. With one row, the braced initializer matches std::array's
implicit **copy** deduction candidate rather than the element guide, so the outer array collapses
into the inner one and `eyeDefinitions[i][0]` no longer compiles. With two or more rows it
deduces correctly. So it would have compiled for every multi-eye configuration and broken only
the shipped single-eye default. Fixed by using a plain array of `std::array`, whose extent the
compiler counts anyway, surfaced as `constexpr size_t EYE_SET_COUNT{std::size(eyeDefinitions)}`.

### "hazel looks off": authored differently, not broken

Operator bench report this session. Diagnosed without hardware, and the conclusion is that
nothing is wrong with the code:

- `hazel.h`, `polarDist_240_125_60_0.*`, `disp_240_125.*` and `polarAngle_240.*` are all
  byte-identical to upstream (`diff`), so the CG-S15 copy is not corrupt.
- `backColor` and `squint` are read by *identical expressions* in CyclopsGaze's `EyeController`
  and upstream's (lines 235/321/435 here, 260/370/507 there). The 305-line divergence between
  the two engines does not touch either. This engine renders hazel the way upstream would.
- Four authored parameters differ from `nordicBlue`: `backColor` 35138 versus 0, iris radius 60
  versus 69, pupil range 0.30-0.70 versus 0.25-0.47, squint 0.5 versus 1.0. `backColor` is
  painted where the eyeball ends but the eyelid aperture continues, so hazel draws a coloured rim
  where `nordicBlue` draws black. Cross-check on the decoding: upstream's own `config.eye` for
  hazel writes `"backColor": "0x8942"`, and Adafruit's M4_Eyes format writes comparable values as
  RGB triples like `[140,40,20]`, consistent with 0x8942 being a dark rust rather than anything
  neutral.
- Which of the four the operator is reacting to is not established, because nothing here was
  observed on the display. All four are now documented per-eye for all ten designs in the
  `config.h` header comment and the README table, which is the durable fix: the next person
  picking an eye can predict the look instead of re-running this diagnosis.

### Status

`FIRMWARE_VERSION` CG-S15 → **CG-S16**. Both builds clean on Teensy 4.1: single-eye code 83,836
/ data 362,056 / RAM1 free 413,824, and `-DDUAL_EYE` code 84,028 / data 362,056.

**CG-S16 is REPO-ONLY. Nothing was flashed this session and no eye was observed changing.** The
board and the source now deliberately disagree: the board runs CG-S15 with two eye sets, the
source is CG-S16 with one, and the version string is what tells them apart on the next boot.

Checks that would confirm CG-S16, on the next flash:
1. Boot line reads `[CG] CyclopsGaze CG-S16` and `EYE sets=1 start=nordicBlue`. **PASSED**
2. `EYE?` lists one set; `EYE:next` is a no-op; nothing rotates on the 20 s timer. **PASSED**
3. Uncomment a second eye's `#include` and row, reflash, and confirm both the new artwork renders
   and gaze tracking survives a swap without a jump or freeze. **Not done.**
4. The still-outstanding items from CG-S13: PS_CFG parse/ack/readback, facing gate, LOST_MS
   resume, plus step 10 (dual-eye) and step 11 (frame rate), neither ever executed.
   **Readback and the unknown-key guard PASSED; the rest not done.**

### CG-S16 flashed and read on the wire, same session (COM6)

The operator flashed the T4.1 and the USB serial was read directly, so this section is
observation, not inference. Boot output and command responses are transcribed in CHANGELOG.md
CG-S16. What it settles:

- **CG-S16 is DEPLOYED.** `VERSION` returns `[CG] CyclopsGaze CG-S16`, matching `config.h`, which
  is the repo's stated bar for the word.
- **`PS_CFG?` works and the seeds are being applied.** The dump reads
  `CONF=60 FACING=0 LOST_MS=3000 X_GAIN=1.70 Y_GAIN=1.70 X_BIAS=0.00 Y_BIAS=1.26 LED=0`, which is
  every `*_DEFAULT` from `config.h`, so the CG-S13 runtime-variable seeding is correct on
  hardware. This was the readback that existed specifically because a standalone board has no
  `ps_config.json`, and it had never been run until now.
- **The false-ack guard holds.** `PS_CFG:BOGUS=1` answers `[DBG] PS_CFG UNKNOWN key BOGUS` and
  emits no ack line, which is the S212c behaviour the CG-S13 port was supposed to preserve.
- **`EYE_SET_COUNT` behaves at 1.** `EYE?` reports `count=1`, and `EYE:next` computes
  `(0 + 1) % 1 = 0` and reports `set=0 name=nordicBlue (next)` rather than indexing out of range.
  The CG-S16 array-extent change is sound on hardware, not just at compile time.
- **The sensor is alive:** `SEN0626 found at 9600 (attempt 1)`, first attempt, so the CG-S3 baud
  hardening and the UART wiring are both fine.

Not settled, and worth stating plainly: **no `faces=` line was seen**, so nothing here exercises
the gate, the gaze math, or the eye's motion. Those still rest on the operator's CG-S15 video.
A `PS_CFG:X_GAIN=` ack was deliberately not sent, to avoid perturbing live tuning while the
operator was observing the display.

### Open: display jitter/flicker (operator, bench, CG-S16)

Reported this session, undiagnosed, wiring is all dupont jumpers on a breadboard.

Ruled out already: bring-up. The display reports `Init GC9A01A display #0: rotate=0, mirror=1`,
`useFrameBuffer() OK` and `Success`, and `_t3n::begin` confirms the intended pins and clocks
(`mosi:11 SCLK:13 CS:10 DC:2 SPI clocks:20000000 2000000`).

Suspects in the order they should be tested, cheapest first:

1. **SPI signal integrity.** `SPI_SPEED` is `20'000'000` (`config.h`). Dupont jumpers on a
   breadboard are a poor transmission line at 20 MHz: unshielded, no ground return paired with
   SCK/MOSI, breadboard stray capacitance. Halving to 10 MHz is a one-line change and is the
   discriminator. Note the CG-S14 render analysis: at 20 MHz a full 115,200-byte frame is already
   a ~21 FPS bus-time ceiling, which is why `updateChangedAreasOnly(true)` exists
   (`GC9A01A_Display.cpp:22`), so a lower clock trades refresh headroom for margin.
2. **The 3.3 V rail, measured at the display's own VCC pin under load**, not at the Teensy pin.
   This project has already lost a bench session to exactly that distinction: CG-S5 found 2.6 V at
   the SEN0626 against 3.25 V at the Teensy, caused by a bad connector in the run.
3. **The refresh rate itself.** If the artefact is uneven or low refresh rather than corrupt
   pixels, no SPI tuning will touch it. `SHOW_FPS` is still commented out at
   `src/displays/Display.h:5` and BENCH_PROTOCOL step 11 has **never been executed on any board**,
   so there is no baseline to judge against. With the rig assembled and flashed, this is the
   cheapest that measurement will ever be.

**Resolved the same session: it was suspect 3.** See CG-S17 below. Suspect 1 was tested and
eliminated, suspect 2 is demoted but not closed.

## CG-S17 (2026-07-25): the flicker was the frame rate, and the first FPS numbers

### The negative result that solved it

CG-S17 halved `SPI_SPEED` to 10 MHz purely as a discriminator. The operator reported the flicker
**persisted, worst on the white sclera**, with **3.12 V at the display** and the newly-enabled
on-screen FPS digits **inverted relative to the eye**. All three pointed somewhere better than
where they were aimed.

Enabling `SHOW_FPS` produced the numbers, and they are the whole diagnosis:

| Configuration | Measured FPS | Full-frame bus-time ceiling |
|---|---|---|
| 10 MHz SPI, synchronous | **10-19**, mostly 10-12 | ~10.8 |
| 30 MHz SPI, async DMA | **20-22** | ~32 |

The 10 MHz row lands *exactly* on its own bus ceiling, and that is the structural finding:
**the display pushes near-full frames every update, so it is bus-bound, not compute-bound.**
`updateChangedAreasOnly(true)` cannot save much because the eye aperture is 43,312 of the 57,600
pixels on screen (CG-S14's measurement), so "changed" is three quarters of the panel. A 10 to
15 Hz refresh across a large white field is itself the flicker, which explains why the sclera
showed it worst, and why lowering the clock made the symptom worse rather than better.

Signal integrity is therefore **ruled out** as the cause, which is exactly what the A/B was for.

### Two upstream values this repo had silently diverged from

Neither divergence had a recorded reason, and both cost frame rate:

| Knob | CyclopsGaze before | Upstream TeensyEyes | Now |
|---|---|---|---|
| `SPI_SPEED` | 20 MHz since CG-S1 | 30 MHz | 30 MHz |
| `asyncUpdates` | `false` on every display | `true` on both | `true` |

Async is the larger win. It hands the framebuffer to DMA so the next frame renders while the
current one is still on the wire, instead of the loop stalling for the entire transfer.
`EyeController::renderFrame()` already supported it, returning early on `!isAvailable()` which is
`!asyncUpdateActive()`. Synchronous updates were costing roughly half the achievable frame rate
for no benefit anyone had written down.

**Worth generalising:** this repo bundles upstream code but had drifted from upstream's *tuning*
in two places at once. When a bundled-upstream subsystem underperforms, diff the configuration
against upstream before theorising about hardware.

### Why the on-screen counter read inverted, and why it moved to serial

`drawNumber(fps, 110, 110)` writes in the panel's coordinate space. The eye artwork additionally
receives the software X-flip that `EyeController` applies unconditionally for `eyeIndex==0`, the
pair-mirror convention CG-S6 traced. Text never gets that second flip, so the digits and the eye
*must* disagree; nothing is misconfigured. Rather than compensate, the counter now prints
`[CG] FPS display=N nn` once a second: off the artwork, in the right orientation by construction,
readable over the wire, and no longer costing draw time that biased the number it reports. This
is a deliberate modification to bundled TeensyEyes, noted in ATTRIBUTION.md.

### Gaze chain observed, and the confidence gate found sitting on the noise floor

The 30 MHz run is the first time this repo has observed its own gaze pipeline since CG-S12
rewrote it:

```
[CG] faces=1 rawScore=62 conf=62 gate=PASS | rawX=492 rawY=82
[CG]   -> raw=0.54,-0.66  target=0.91,0.13  (gain 1.70/1.70 bias 0.00/1.26)
```

So CG-S12's raw-score gate and per-axis gain/bias are bench-observed, not merely compiled. That
retires the oldest outstanding item in this log.

It also exposed a tuning problem that only live data could show. Scores oscillate between 60 and
79 for a stationary face, and land on `gate=REJECT` at exactly 60 repeatedly, so
`PS_CONF_GATE_DEFAULT = 60` sits **on the noise floor** at bench distance and the eye keeps
acquiring and dropping the same face. DFRobot's "score >= 60 is valid" is a vendor
recommendation, not a measurement of this unit at this range and lighting, and CG-S5 adopted it
from the datasheet rather than from data. Live-tuned to `CONF=50` with `PS_CFG:CONF=50`.

Deliberately **not** written back into `config.h`. One sitting at one distance in one lighting
condition does not justify changing a documented vendor floor; that needs a sweep. The value is
RAM-only and reverts on reset, which is what the CG-S13 protocol is for.

That same command **VERIFIED the last unproven `PS_CFG:` path, the ack**: `[DBG] PS_CFG CONF=50`
in IRIS's exact wording, confirmed by a readback reporting `CONF=50`.

### Status

**CG-S17c is DEPLOYED.** Boot line and `SPI clocks:30000000 2000000` both observed on COM6.

Newly VERIFIED at CG-S16/S17, all previously owed: the `PS_CFG?` readback, the `PS_CFG:` ack, the
unknown-key guard, `EYE?`/`EYE:next` at one set, the gaze chain end to end, and the frame rate.

**Flicker: CLOSED.** Operator, same session, after the 30 MHz async build: *"looks better, mostly
fixed, observable only with close inspection."* The chain of reasoning held up end to end: a
negative A/B eliminated signal integrity, the first FPS measurement identified refresh rate, and
adopting upstream's two values roughly doubled it. The 3.12 V at the display was **not** the
cause and never needed chasing, which is worth remembering next time a rail reads slightly low:
CG-S5's 2.6 V was a real fault, 3.12 V was a red herring. Async tearing did not appear.

Still open:
- **The residual artefact at 20-22 FPS, and which of two things bounds it.** A full frame at
  30 MHz is 115,200 x 8 / 30e6 = 30.7 ms, a 32.5 FPS ceiling, but 20-22 FPS means 45-50 ms per
  frame. Either async fully overlaps and the render itself takes ~45-50 ms, in which case a
  faster clock buys nothing and the only lever is the 214,492 table reads per frame that CG-S14
  measured; or the transfer is only partly hidden, in which case clock still helps. **A single
  flash at 40 MHz distinguishes them:** flat means render-bound, a rise means bus time is still
  exposed. Not attempted, because 30 MHz is upstream's proven value and exceeding it on dupont
  wiring reintroduces exactly the signal-integrity risk this session eliminated.
- `CG_CALIB_RAW` prints two lines per sensor sample and `SHOW_FPS` prints one a second. Both are
  bench instrumentation and should be turned off before any demo build.
- Unchanged: facing gate, `LOST_MS`/autoMove resume, NATIVE_H, a second eye rendering, dual-eye
  step 10.
