Maestro8484/CyclopsGaze/src/displays/GC9A01A_Display.cpp

#include "GC9A01A_Display.h"

GC9A01A_t3n *createDisplay(const GC9A01A_Config &config) {
  // If project involves only ONE eye and NO other SPI devices, its select line can be
  // permanently tied to GND and corresponding pin set to -1. Best to use it though.
  if (config.cs >= 0) {
    pinMode(config.cs, OUTPUT);
    digitalWrite(config.cs, HIGH); // Deselect them all
  }
  return new GC9A01A_t3n(config.cs, config.dc, config.rst, config.mosi, config.sck);
}

GC9A01A_Display::GC9A01A_Display(const GC9A01A_Config &config, uint32_t spiSpeed) :
    display(createDisplay(config)), asyncUpdates(config.asyncUpdates) {
  static size_t displayNum{};
  Serial.print(F("Init GC9A01A display #"));
  Serial.print(displayNum);
  Serial.print(F(": rotate="));
  Serial.print(config.rotation);
  Serial.print(F(", mirror="));
  Serial.println(config.mirror);
  display->updateChangedAreasOnly(true);
  display->begin(spiSpeed);
  display->setRotation(config.rotation);
  if (config.mirror) {
    const std::array<uint8_t, 4> mirrorTFT{0x8, 0x20, 0x40, 0xE0}; // Mirror + rotate
    display->sendCommand(GC9A01A_MADCTL, &mirrorTFT.at(config.rotation & 3), 1);
  }

  if (config.useFrameBuffer) {
    Serial.print(displayNum);
    Serial.print(F(": useFrameBuffer() "));
    if (!display->useFrameBuffer(true)) {
      Serial.println(F("failed"));
    } else {
      Serial.println(F("OK"));
    }
  }
  Serial.println(F("Success"));
  this->displayNum = displayNum;
  displayNum++;
}

GC9A01A_Display::~GC9A01A_Display() {
  // TODO: this looks like a bug in GC9A01A_t3n, it is meant to have a virtual destructor.
  //  about the best we can do is just free the frame buffer :-/
  // delete display;
  display->freeFrameBuffer();
}

void GC9A01A_Display::drawPixel(int16_t x, int16_t y, uint16_t color565) {
  display->drawPixel(x, y, color565);
}

void GC9A01A_Display::drawFastVLine(int16_t x, int16_t y, int16_t height, uint16_t color565) {
  display->drawFastVLine(x, y, height, color565);
}

void GC9A01A_Display::drawText(int16_t x, int16_t y, char *text) {
  display->setCursor(x, y);
  display->setTextSize(2);
  display->setTextColor(WHITE, BLACK);
  display->print(text);
}

void GC9A01A_Display::update() {

#ifdef SHOW_FPS
  // A per-display FPS counter. CG-S17b: reports over SERIAL instead of drawing
  // onto the eye. Upstream drew it with drawNumber() at (110,110), which has
  // three problems here: it sits on top of the artwork, it renders in the
  // panel's own orientation rather than the eye's (the eye receives an extra
  // software flip for the eyeIndex==0 pair convention that text does not, so
  // the digits read inverted relative to the eye, observed on the bench at
  // CG-S17), and drawing it every frame costs time that biases the very number
  // being measured. Printing once a second measures the render loop without
  // perturbing it. This is a deliberate divergence from bundled TeensyEyes,
  // recorded in docs/ATTRIBUTION.md.
  framesDrawn++;
  if (elapsed >= 1000L) {
    fps = framesDrawn;
    framesDrawn = 0;
    elapsed = 0;
    Serial.printf("[CG] FPS display=%d %lu\n", displayNum, (unsigned long)fps);
  }
#endif

  if (asyncUpdates) {
    if (!display->updateScreenAsync()) {
      Serial.print(F("updateScreenAsync() failed for display "));
      Serial.println(displayNum);
    }
  } else {
    display->updateScreen();
  }
}

bool GC9A01A_Display::isAvailable() const {
  return !display->asyncUpdateActive();
}
