Maestro8484/CyclopsGaze/(commit log)

2026-06-24 CG-S1: initial CyclopsGaze -- SEN0626 Modbus RTU driver + single GC9A01A eye tracking
2026-06-24 Fix gaze tracking: center box, remove /3.0f bias, auto-move timeout
    - SEN0626Sensor: store face center directly in box_left/right/top/bottom
    instead of ±32 synthetic box; clamping was shifting recovered center
    by up to 32px at frame edges
    - main.cpp: read box_left/box_top directly as cx/cy (exact center,
    no /3.0f denominator which only makes sense for a real face rect)
    - main.cpp: move timeSinceFaceDetectedMs() check outside sensor.read()
    gate so auto-move resumes after Modbus dropout, not just clean reads
    - SEN0626Sensor.h: remove unused BOX_HALF constant
    targetY sign kept matching IRIS production formula (not negated).
    Bench verification of Y direction still required.
    Co-Authore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
    [SEN0626Sensor.cpp, SEN0626Sensor.h, main.cpp]
2026-07-04 CG-S2: target Teensy 4.1, clean build, validate PS drop-in contract
    - platformio.ini board teensy40 -> teensy41 (T4.1 arrived 2026-07-03;
    pins identical per 05_WIRING.md, only board line changed)
    - FIRMWARE_VERSION CG-S1 -> CG-S2
    - Clean T4.1 build verified (74KB flash, no warnings)
    - Confirmed SEN0626 shim person_sensor_face_t + method surface match IRIS
    src/sensors/PersonSensor.h byte-for-byte (true drop-in)
    - NOTES.md: real build results, is_facing=1 gap documented, center-in-both-
    edges box model, bench-verify checklist (no T4.1 enumerated this session)
    Status: REPO-ONLY -- not flashed (no Teensy connected to SuperMaster)
2026-07-04 docs: add CyclopsGaze scaffolding (setup, rules, handoffs, wiring, reviews)
    Operator-authored session-primer/handoff/wiring/peer-review/gesture-
    integration docs referenced as sources of truth. Tracking so they persist.
2026-07-04 docs: frame CyclopsGaze as future-proofing / public-launch, bench-only
    Live Person Sensor works fine now; CyclopsGaze is a drop-in replacement for
    the DISCONTINUED SEN-21231 -- insurance + publicly-replicable launch path.
    Flash/verify later on a spare NON-INSTALLED T4.1; live PS stays source of
    truth. No live-IRIS change.
2026-07-04 CG-S3: declared durable gaze-node repo + IRIS PS-bus drop-in integration plan (HANDOFF C)
    Docs/architecture only, no firmware change. Decision (IRIS HANDOFF C, 2026-07-04):
    CyclopsGaze is the durable gaze-node identity (OGLE archived, not folded-forward);
    integration path = native Person-Sensor-bus drop-in (SEN0626 shim read directly by
    IRIS's own T4.1, I2C->UART), not the OGLE USB-CDC->Pi4 bridge.
    - add 09_IRIS_INTEGRATION_PLAN.md: I2C->UART bus change, enumerated IRIS edits,
    behavioral-gap handling (is_facing non-blocking via psFacingRequired=false S153c;
    confidence-scale bench flag vs CONF=60; coord/flip verify), bench gate, rollback
    - add CHANGELOG.md (CG-S1/S2/S3)
    - README: T4.1 id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
2026-07-05 CG-S3: harden SEN0626 driver (Modbus timeout, baud boot/retry, raw calib)
    - Modbus response timeout 300->100ms (MODBUS_RESP_TIMEOUT_MS): caps a
    stalled-read eye freeze at 100ms while keeping ~4x margin over the ~25ms
    normal round trip at 9600 baud (audit 3.6).
    - begin() now holds until 2s post power-on before the first probe (the SEN0626
    boots an AI model into RAM), trims per-baud settle to 200ms, and retries the
    full 115200->9600 sweep 3x (BOOT_SETTLE_MS/BAUD_ATTEMPTS, audit 3.9).
    - Store + expose rawFaceX/Y/Score for bench calibration of NATIVE_H (480 vs 640)
    and confidence scale; additive accessors, drop-in contract intact (audit 3.5).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
    [SEN0626Sensor.cpp, SEN0626Sensor.h]
2026-07-05 CG-S3: config tunables + optional DUAL_EYE; bump FIRMWARE_VERSION
    - FIRMWARE_VERSION CG-S2 -> CG-S3.
    - Centralise bench tunables: PS_CONF_GATE (45, matches IRIS S153c), GAZE_GAIN
    (1.0), FACE_LOST_MS (3000), CG_CALIB_RAW (raw serial logging on by default).
    - DUAL_EYE: uncomment to drive a second GC9A01A. Resolves a T4.1 pin conflict --
    IRIS's second bus (SPI1) collides with Serial1 on BOTH pin 0 (SPI1 CS) and
    pin 1 (SPI1 MISO), so both eyes share SPI0 with separate CS (eye1 CS9/DC8/RST6).
    mirror flags match IRIS left/right so the eyes track together (section 4).
    [config.h]
2026-07-05 CG-S3: gate confidence, add gaze gain + raw calib logging in tracking loop
    - Add confidence gate (box_confidence > PS_CONF_GATE) matching IRIS; previously
    CyclopsGaze tracked any detection ungated. Effective min score ~19/100 (audit 3.7).
    - Apply GAZE_GAIN to targetX/targetY for bench range-tuning (clamped to unit
    circle downstream, so gain >1 is safe); range verified to match IRIS (audit 3.8).
    - Log raw sensor values under CG_CALIB_RAW for NATIVE_H / confidence calibration
    (audit 3.5). Move the 3s lost-timeout to FACE_LOST_MS.
    - Y-direction left as-is: sign convention is byte-for-byte IRIS production
    main.cpp on the identical EyeController, so it is correct, not inverted; any
    resi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
    [main.cpp]
2026-07-05 CG-S3: docs -- audit findings, bench protocol, dual-eye wiring, IRIS gate
    - NOTES.md: full CG-S3 audit verdicts (3.1-3.10, incl non-bugs confirmed) and
    the complete 10-step first-flash bench protocol (replaces the placeholder).
    - 05_WIRING.md: T4.1 identity + Dual-Eye (optional) section with pin table and
    the SPI1-vs-Serial1 conflict resolution; updated baud auto-detect steps.
    - CHANGELOG.md: CG-S3 Part B (firmware audit + dual-eye).
    - 09_IRIS_INTEGRATION_PLAN.md: section 6 gate updated -- what CG-S3 unblocked
    code-side vs what stays RED until the bench pass.
    - Add 10_OPUS_HANDOFF.md (this session's handoff).
2026-07-07 CG-S4/CG-S5: ungate calibration logging, re-derive PS_CONF_GATE from vendor spec
    - CG-S4: calibration log line previously only printed inside the
    confidence-gated branch, so it vanished the instant a detection dropped
    below PS_CONF_GATE -- exactly the boundary data needed for range/gate
    tuning. Now logs every raw detection (rawScore/conf/gate=PASS|REJECT/
    rawX/rawY) regardless of gate outcome; the eye still only moves on PASS.
    - CG-S5: PS_CONF_GATE was borrowed from IRIS's unrelated psConfGate constant
    (45), an effective SEN0626 score floor of only ~19/100. Replaced with
    DFRobot's own documented validity floor (wiki.dfrobot.com/sen0626/docs/23024:
    "a score >=60 is considered va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
    [config.h, main.cpp]
2026-07-07 CG-S5: wiring reference -- DIP-switch fix, power-fault finding, distance floor
    - Cross-referenced wire colors against IRIS (which documents pins only, no
    colors) and rebuilt the palette around the operator's fixed SEN0626 TX/RX
    colors (Green/Blue) with zero repeats across the single-eye+sensor system.
    - Documented the SEN0626's onboard I2C/UART DIP switch: must be set to UART,
    confirmed on bench as the root cause of an earlier NOT FOUND.
    - Documented the bench-found power fault (2.6V at sensor VCC vs 3.25V at the
    Teensy's own 3.3V pin, traced to a bad connector) as a first-check item --
    undervolting is a documented SEN0626 forum failure mode.
    - Added a Mounting Distance section: DF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
2026-07-07 CG-S5: bench findings -- DIP switch, power fault, vendor-spec research
    - Documented bench session progress: SEN0626 found (DIP-switch fix), power
    fault found+fixed, PS_CONF_GATE re-derived from DFRobot's own spec (audit
    3.7 updated).
    - Added "External research" section: DFRobot's documented 0.5-3m detection
    range, 85 degree diagonal-only FOV (no H/V split published), forum-confirmed
    failure modes (power/wiring dominant, matches this session's own finding),
    and an honest gap noted for the Person Sensor comparison (no public FOV/
    distance spec found -- qualitative comparison only, flagged for the IRIS
    integration gate decision).
    - Added bench step 7b: re-test lateral (X-axis) tra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
2026-07-07 CG-S5: propagate vendor-derived confidence gate + distance-floor finding to IRIS gate
    - Section 5 confidence-scale row updated: PS_CONF_GATE is now DFRobot's own
    documented floor, not IRIS's borrowed constant.
    - Section 6 gate checklist updated with this session's bench progress (DIP
    switch, power fault, confidence check) and a new consideration: the
    SEN0626's documented 0.5-3m floor sits at typical close conversational
    distance, which may be a genuine downgrade vs the Person Sensor for IRIS's
    actual use case -- flagged for the deploy decision, not just tuning.
2026-07-07 CG-S5: changelog entries + handoff doc for lateral-tracking investigation
    - CHANGELOG CG-S4/CG-S5 entries (this session's full bench findings).
    - Add 11_HANDOFF_FABLE_LATERAL_TRACKING.md: self-contained next-session brief
    for the still-open lateral (X-axis) tracking instability -- what's already
    fixed, how to re-test before changing code, how to tell noise/clipping/
    systematic-error apart, and the IRIS panServo low-pass-filter pattern as the
    leading candidate fix if it turns out to be sensor noise.
2026-07-07 CG-S5: add all-in-one copy-pastable handoff for lateral-tracking session
    Self-contained onboarding doc for a fresh Claude session (Fable/Opus) picking
    up the open lateral (X-axis) tracking investigation -- inlines the current
    main.cpp/config.h state, what's already fixed this session, the sourced
    DFRobot/Person-Sensor research, and the diagnostic decision table, so a new
    session can act without first re-reading the whole repo. Complements (does
    not replace) 11_HANDOFF_FABLE_LATERAL_TRACKING.md.
2026-07-08 CG-S8: lateral-tracking VERIFIED, gaze tuned, ready for IRIS integration
    - CG-S6: fix mirrored X (double flip: main.cpp negation + EyeController
    eyeIndex==0 flip on single eye) -- remove main.cpp negation.
    - CG-S7: GAZE_GAIN 1.0 -> 1.7 from measured rawX span 151-427.
    - CG-S8: add Y_CENTER=33 -- sensor mounts below eye, eye-level images near
    frame top; old code used 127.5 as neutral so eye was pinned up.
    - Upward-gaze ceiling documented as hardware/mount limit (not code).
    - LED confirmed non-disableable in firmware (no Modbus register); physical
    cover only. Docs: NOTES.md status VERIFIED, CHANGELOG CG-S6/S7/S8.
    [config.h, main.cpp]
2026-07-08 CG-S9: IRIS integration -- code-review pass + both-consumer drop-ins
    Reviewed the SEN0626 drop-in against IRIS's actual source (read-only). No
    CyclopsGaze tracking change -- tracking stays VERIFIED (CG-S8).
    - Found the T4.0 servo as a SECOND Person Sensor consumer (X-only pan) with a
    different interface than the T4.1 eyes class. Added a SEN0626-backed adapter:
    integration/servo_teensy40_base_mount/person_sensor.{h,cpp} preserving the
    setupPersonSensor/pollPersonSensor/PersonResult contract; .ino unchanged.
    - Eyes: verified method surface + struct are a true drop-in. Closed the begin()
    gap -- SEN0626Sensor::isPresent() now lazy-begins so IRIS's isPresent() probe
    loop works with no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
2026-07-08 CG-S9: confirm IRIS has two Person Sensors (one per Teensy) -- kit assumption matches
2026-07-15 CG-S10: camera module bench-confirmed physically separable from main PCB
    SEN0626 lens/sensor attaches via ribbon + tape, not solder. Bench-tested with
    camera detached from the main board (LEDs, gesture RGB, IR components absent):
    face detect/track still worked through the ribbon alone. Closes the mounting-
    footprint gap vs the tiny Person Sensor this project stands in for. Register
    identity (I2C/UART addr/baud) once separated is flagged unverified - do not
    build public wiring instructions to this until confirmed.
2026-07-18 CG-S12: sync IRIS refinements + reorganize for public GitHub release
    Code sync (WARNING: UNVERIFIED on the standalone bench -- re-run
    docs/BENCH_PROTOCOL.md is the #1 priority on next flash with a spare SEN0626):
    - SEN0626Sensor emits the raw DFRobot score (0-100) as box_confidence
    - PS_CONF_GATE 152 -> 60 and servo PS_SERVO_CONF_GATE 152 -> 60 (raw 0-100 scale)
    - main.cpp gaze math -> IRIS per-axis signed gain+bias (GAZE_X/Y_GAIN, GAZE_X/Y_BIAS),
    defaults algebraically identical to the bench-VERIFIED CG-S6/S7/S8 behavior
    - FIRMWARE_VERSION CG-S9 -> CG-S12; builds clean single-eye and dual-eye
    Public-release reorganization:
    - Add LICENSE (MIT + bundled TeensyEyes / Chris Miller attributio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
2026-07-19 docs: accurate authorship/attribution (derivative-work split)
    Clarify original-vs-bundled at file level after diffing against pristine
    chrismiller/TeensyEyes:
    - README: add "Authorship & originality" section
    - docs/ATTRIBUTION.md: add file-level original-vs-bundled table
    - Credit the nordicBlue eye texture as the author's own art (generated from
    their own iris/sclera image via TeensyEyes tooling); eyelid geometry and
    polar/displacement maps remain TeensyEyes; SEN0626 driver + gaze/integration
    layer are original.
2026-07-21 CG-S13: second sync from live IRIS -- SEN0626_SERIAL knob + PS_CFG live tuning
    Diffed both repos and read the running Pi4 before editing. Most of IRIS's
    firmware was already here: SEN0626Sensor.{h,cpp} differ by comment text only
    (zero code difference), and IRIS's gaze code is frozen at S212c -- its last
    main.cpp/config.h commit (S213) changed only PROTOCOL_VERSION. So there was no
    un-synced IRIS code change; the real drift was elsewhere.
    What came back:
    - SEN0626_SERIAL config knob. Live IRIS runs the sensor on Serial4 (RX16/TX17),
    not Serial1 -- pin 0 is its left-eye CS. Two docs here claimed Serial1; both
    corrected. Default stays Serial1 (this rig's bench-VERIFIED wiring).
    - The PS_C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
    [SEN0626Sensor.cpp, config.h, main.cpp]
2026-07-21 docs: hardware/ scaffold for STL + laser-cut mounts, README refresh for CG-S13
    Adds hardware/stl/ and hardware/lasercut/ as an explicit scaffold for future
    mount designs, with placeholder READMEs stating what's needed (no physical
    dimensions for the GC9A01A, SEN0626 Gravity board, or their mounting holes are
    recorded anywhere in this repo yet) and flagging the open full-board-vs-
    detached-camera design fork from CG-S10 (docs/ENGINEERING_LOG.md) that any
    mount design needs to pick a side on. No STL/SVG geometry included -- nothing
    here has been measured against the real hardware, so generating placeholder
    "mount" files would be unverified content someone could print/cut as if it fit.
    Also re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
2026-07-21 docs: editorial pass across all docs + add scripts/flash_com6.bat
    Reformatting/tightening pass over every markdown file (not authored in this
    session -- reviewed before committing). Verified as editorial, not content loss:
    - Word-level diff (markdown emphasis stripped) shows net changes are de-bolding,
    de-capitalizing emphasis (VERDICT:/NOT/MUST/ONLY -> lowercase), unit spacing
    (3.3 V -> 3.3V, 0.5 m -> 0.5m, ~3 s -> ~3s), dropped '>' blockquote and warning
    decoration, and line rewrapping. Prose was tightened in places.
    - Every removed line has a reworded '+' counterpart; no sections dropped.
    - Spot-checked that all load-bearing facts survive in the working tree: device
    addr 0x72, SE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
2026-07-22 CG-S14: ESP32-S3 migration feasibility study (docs only, no code)
    Exploratory study of moving off the Teensy 4.1, driven by BOM cost /
    public replicability. No source file touched; FIRMWARE_VERSION stays
    CG-S13. Clean build re-confirmed (FLASH code 82876, RAM1 free 413824 --
    identical to CG-S13, as expected for a docs-only change).
    Audited against live source, not recalled:
    - EyeController.h (read in full), eyes.h and all ~18k lines of LUT data
    are portable unchanged. The render engine was expected to be the
    blocker and is not.
    - GC9A01A_t3n is unportable and must be replaced. Its library.json
    claims "platforms": "*" -- false. Gated on __IMXRT1062__/KINETISK,
    includes DMAChannel.h,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
2026-07-22 docs: disambiguate CG-S14 from the CG-S3 ESP32-S3 tombstone
    CHANGELOG CG-S3 Part A retires "the ESP32-S3 + OV2640 approach" (OGLE).
    A future session reading that alongside CG-S14 would see a contradiction.
    There isn't one, and the study didn't say so.
    OGLE was retired because on-chip vision on an S3 wasn't good enough --
    the S3 ran the OV2640 and the esp-dl inference itself. This proposal
    gives the S3 no vision workload at all: the SEN0626 does its own
    inference and reports a face center over Modbus, exactly as it does for
    the Teensy today. The retired verdict is about a workload this design
    does not have.
    The genuinely new risk is the render load, which OGLE never carried --
    it fed gaze t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
2026-07-22 CG-S14: sourced BOM + corrected board choice; tables run from flash
    Adds docs/BOM.md and reframes the README around the standalone build.
    Corrects two claims from 96d9db1 that were disproved later in the session.
    CORRECTION 1: the SRAM-residency plan was built on an unchecked premise.
    arm-none-eabi-size -A on the linked Teensy binary shows .text.progmem at
    352136 bytes at 0x60002574 (external QSPI flash), with only .data 9920
    and .bss 2240 in RAM. The bench-VERIFIED Teensy build already streams all
    352 KB of tables from flash through its cache. So tables-in-flash is the
    baseline, SRAM residency is an S3-only optimization, the "one eye design"
    limit is void, and PSRAM is not required.
    CORRE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
2026-07-22 docs: build paths in README, frame-rate bench step, fix broken hero image
    Three fixes and one addition, all docs. No source changed;
    FIRMWARE_VERSION stays CG-S13 and the build is clean.
    README: new "Build paths" section giving four routes to a working eye,
    each with cost, ordered steps, doc links and an honest status. Path A
    (single tracking eye, Teensy) is the VERIFIED one and is marked as the
    place to start. Path B is the no-camera wandering prop. Path C is
    dual-eye, which compiles but has never run on hardware. Path D is the
    unbuilt ESP32-S3 cost-reduction path. Closes with a pick-by-what-you-want
    table so a newcomer does not have to infer the risk ordering.
    FIX: the hero image pointed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
2026-07-22 CG-S15: second eye set (hazel) + 20s rotation + EYE: serial protocol
    The firmware carried exactly one eye set (nordicBlue) since CG-S1. It now
    carries two and switches between them on a timer or on command.
    Added hazel, copied verbatim from upstream TeensyEyes along with the
    polarDist_240_125_60_0 table it needs (hazel uses iris radius 60,
    nordicBlue uses 69, so the existing _69_0 table could not be reused).
    polarAngle_240 and disp_240_125 were already present and are shared.
    hazel is Chris Miller's work in its entirety, artwork included;
    ATTRIBUTION.md and the README credits updated to say so plainly, since
    until now the only bundled eye's texture art was original to this project.
    Prior a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
2026-07-25 CG-S16: demo-video captions + post copy; flag the unlogged bench session
    Media only, no source touched, FIRMWARE_VERSION stays CG-S15.
    - docs/media/VIDEO_CAPTIONS.md: three caption drafts for the 39s demo clip
    (build-log cold open, retention cut, documentary), why one shipped, plus
    YouTube title/description, short-form caption, tags and Resolve notes.
    - Shipped CyclopsGaze_captions_v2.srt beside the Resolve project; left the
    existing captions_final.srt alone since it is already burned into a render.
    - Captions written against sampled frames, not the firmware docs: the clip
    shows nordicBlue only, so nothing claims the CG-S15 rotation, and the
    wander-on-face-loss line is a capabilit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
2026-07-25 docs/media: restore the README hero image, commit the hero photo and demo captions
    The README hero has pointed at docs/media/cyclopsgaze_tracking.jpg since CG-S12
    and that file has never existed, so the public page rendered a broken image
    (recorded at CG-S14, commented out as a stopgap). Points at the real file now.
    - Commit CyclopsGaze-hero_photo.jpg: the nordicBlue eye with the SEN0626
    mounted directly below it. Rendered at a constrained width because it is a
    1074x2114 portrait and full width is overwhelming on GitHub.
    - Commit the shipped demo caption SRT alongside VIDEO_CAPTIONS.md.
    - docs/media/README.md: hero is live, and video renders stay out of the repo
    at 32 to 214 MB each.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
2026-07-25 CG-S16: ten selectable eye designs, one enabled, disabled ones cost zero flash
    Bundles 8 more of Chris Miller's eyes (bigBlue, cat, demon, doe, doomRed,
    dragon, fish, skull) plus the 7 polarDist, 2 disp and noeyelids_120 tables they
    need. With nordicBlue and hazel that is 10 selectable designs, all verified
    byte-identical to upstream by diff. Default ships nordicBlue alone, matching the
    operator's own revert: with one set nothing rotates, which is what a
    face-tracking demo wants.
    Prior art, not invention: selection is upstream TeensyEyes' own mechanism, an
    include block paired with array rows, commented in pairs. Its config.h does
    exactly this with 23 eyes.
    A disabled eye costs ZERO flash,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
    [config.h]
2026-07-25 CG-S16 docs: eye artwork survey, hazel diagnosis, and CG-S15 status corrected to DEPLOYED
    New docs/EYE_ARTWORK.md, researched from source repos on 2026-07-25 rather than
    recalled. There is no third-party ecosystem of TeensyEyes eyes: the only public
    fork (MichaelMeissner/TeensyEyes) has an identical eye list, confirmed by API.
    But six MIT-licensed Adafruit designs were never ported to TeensyEyes at all
    (terminatorEye, goatEye, naugaEye, noScleraEye, defaultEye from Uncanny_Eyes, and
    reflection from M4_Eyes), and the real blocker is recorded: config.eye is two
    incompatible schemas, upstream's nested/hex-colour/PNG-lid form against M4_Eyes'
    flat/RGB-triple/eyelidIndex form. Also records that t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
2026-07-25 CG-S16 is DEPLOYED: version confirmed on COM6, PS_CFG readback and EYE: verified
    The T4.1 was flashed and the serial link read directly, so this is observation.
    VERSION returns [CG] CyclopsGaze CG-S16, matching config.h, which is the repo's
    stated bar for DEPLOYED.
    Closed, after being owed since CG-S13:
    - PS_CFG? readback works, and the dump reads CONF=60 FACING=0 LOST_MS=3000
    X_GAIN=1.70 Y_GAIN=1.70 X_BIAS=0.00 Y_BIAS=1.26 LED=0, which is every
    *_DEFAULT in config.h. The runtime seeding is correct on hardware.
    - PS_CFG:BOGUS=1 answers UNKNOWN key BOGUS and emits no ack, preserving the
    S212c false-ack behaviour the CG-S13 port was meant to keep.
    - EYE? reports count=1 and EYE:next com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
2026-07-25 CG-S17 DEPLOYED: SPI 20 -> 10 MHz flicker A/B, and SHOW_FPS enabled for a first frame rate
    Two one-line changes flashed together, both confirmed live on COM6 rather than
    just compiled: boot line reads [CG] CyclopsGaze CG-S17 and _t3n::begin reports
    SPI clocks:10000000 2000000.
    SPI_SPEED 20 MHz -> 10 MHz in both config.h branches. A discriminator for the
    CG-S16 flicker, not a fix: dupont jumpers on a breadboard are a poor
    transmission line at 20 MHz, with no ground return paired to SCK/MOSI. If the
    flicker clears, the cause is signal integrity and the real fix is physical,
    after which the clock can go back up. Halving it costs headroom against the
    ~21 FPS full-frame bus ceiling CG-S14 measur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
    [Display.h, config.h]
2026-07-25 CG-S17c: the flicker was the frame rate. 30 MHz + async DMA, 10-19 FPS -> 20-22
    CG-S17's 10 MHz A/B came back negative and that negative was the useful part.
    The flicker persisted, worst on the white sclera, so signal integrity is ruled
    out. Enabling SHOW_FPS produced this project's first frame-rate numbers on any
    board and they are the diagnosis:
    10 MHz SPI, synchronous : 10-19 FPS (mostly 10-12), bus ceiling ~10.8
    30 MHz SPI, async DMA : 20-22 FPS, bus ceiling ~32
    The 10 MHz row sits exactly on its own full-frame bus ceiling, so the panel is
    pushing near-full frames and is bus-bound, not compute-bound.
    updateChangedAreasOnly(true) cannot help much because the eye ape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
2026-07-25 CG-S17c: flicker confirmed closed on the bench, residual bounded
    Operator, after the 30 MHz async build: 'looks better, mostly fixed, observable
    only with close inspection.' The diagnosis holds end to end: a negative A/B
    eliminated signal integrity, the first FPS measurement identified refresh rate,
    and adopting upstream's SPI_SPEED and asyncUpdates roughly doubled it.
    The 3.12 V at the display was NOT the cause and never needed chasing. Worth
    keeping alongside CG-S5, where 2.6 V was a genuine fault: a slightly low rail is
    not automatically the problem. Async tearing did not appear either.
    Residual artefact is bounded arithmetically rather than guessed at. A full frame
    at 30 MHz is 115,200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
2026-07-25 CLAUDE.md: drop the stale unverified-list bullet superseded by CG-S17
    The gaze chain, the PS_CFG paths and the frame rate were all closed at
    CG-S16/S17, but the older bullet still listed them as never observed and
    contradicted the entries directly beneath it.
2026-07-25 CG-S17d: confidence gate 60 -> 55, and fix the off-by-one in its own comment
    Operator decision from the CG-S17 bench data, written into config.h so it
    survives a power cycle, then flashed and confirmed on COM6: VERSION returns
    CG-S17d and PS_CFG? reports CONF=55 from the compiled default with no runtime
    override.
    60 came from DFRobot's setup guide at CG-S5, adopted from the datasheet rather
    than from data. Live logging showed it is too strict for this unit at bench
    range: a stationary face scored 60-79 and repeatedly landed on exactly 60, all
    of which were rejected, so the eye kept acquiring and dropping the same face. 50
    was live-tuned and held. 55 is the deliberate middle of the two, a ju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
    [config.h]
2026-07-25 docs: settle the SEN0626 LED question with the verified register set
    The protocol doc asserted 'no LED control register exists' without showing the
    evidence. Re-verified at CG-S17d against DFRobot's current library header rather
    than the CG-S8 note, and recorded the complete writable register set: device
    address, baud, parity/stop, face detection threshold, face score threshold,
    gesture score threshold. That is all of it. No LED register, no brightness, no
    indicator enable, so enableLED(bool) {} is correctly a no-op that exists only to
    satisfy the Person Sensor method surface.
    Also records what the two indicators actually are (white head-shoulder light,
    steady while a face is detected; RGB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
2026-07-26 docs/media: merged caption draft (v3), plain wording, IRIS linked publicly
    Draft A read as too technical and Draft C had the engaging voice but the worst
    jargon, so the shipped cut is a merge: C's spine and pacing, A's cue density, and
    every technical phrase rewritten into plain language. 'Face center out over UART'
    became 'the camera sends the face position over two wires'. Kept the beats that
    need no decoding, and gave 'No Pi. No PC. No wifi.' a cue of its own since it is
    the single most impressive claim to this audience.
    Pricing corrected and expanded: about $64 for the build in the video, plus 'a
    second eye is under $12', which is the line that makes a viewer imagine building
    two. BOM.m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
2026-07-26 docs/media: captions bottom centre, and the ffmpeg BorderStyle trap that hid it
    Operator wants the caption block bottom centre, which supersedes the earlier
    upper-third recommendation.
    Root-caused the placement problem rather than working around it: BorderStyle=4,
    the opaque caption box, makes this ffmpeg build ignore both Alignment and MarginV,
    which is why the first burn landed mid-left. Switching to BorderStyle=1 with
    Outline=3 restores normal behaviour, and libass already defaults to bottom centre
    so no Alignment override is needed. Verified by comparing rendered frames.
    Recorded a second trap that made diagnosis harder: putting -ss before -i rebases
    timestamps to zero, so the subtitle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
2026-07-26 docs/media: caption placement fixed to true bottom, and the PlayRes scaling cause
    Operator: captions were still about a quarter up from the bottom. Root cause
    found rather than nudged: ffmpeg's SRT to ASS conversion writes PlayResX 384 /
    PlayResY 288 (confirmed by converting and reading the file), and libass scales
    every script unit by video_height / PlayResY. On 1080p that is x3.75, so
    MarginV=55 rendered ~206 px off the bottom and FontSize=24 rendered ~90 px tall.
    Pixel values passed to force_style are simply wrong by nearly four.
    Fix is deterministic rather than a tuned fudge factor: convert to ASS, rewrite
    PlayRes to the real frame size, and write the style line directly, so numbers
    mea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
2026-07-27 docs/media: handoff for drafting new demo-clip captions
    Written for a session picking up the caption work cold. Follows the handoff
    rules: no hardcoded as-of stamp, an embedded staleness check comparing HEAD
    against the commit that last touched the file itself, the ground-truth rule up
    front, and every state line carrying how it was checked.
    Carries what a new draft actually needs and would otherwise re-derive: the
    frame-by-frame inventory of what is on screen (and the list of things that are
    never on screen, which is where the false-caption traps live), the clip's
    measured specs, the verified numbers and links with their sources, the four
    drafts already tried with the operator's verdicts o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
2026-07-27 docs/media: pasteable chat brief for new caption drafts, wording only
    Different audience from CAPTIONS_HANDOFF.md, which targets a Claude Code session
    with repo access. This one is written to be pasted into a fresh Claude Chat that
    may have no tools at all, so it is fully self-contained: no file references, no
    commands, every fact inline including the current shipped cue list.
    Scoped to wording. Firmware, ffmpeg and git are all stripped out.
    The staleness check sits OUTSIDE the paste block, addressed to the operator,
    because a chat session cannot run git. Intent of the handoff rule is preserved:
    re-verify the hardware and cost lines before pasting, since those are what rot.
    Voice section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
2026-07-27 docs/media: four alternate caption cuts (E-H), structurally different from D
    Not rewordings. Each varies structure, not adjectives:
    E reveal-first inverts D by opening on the discontinued sensor and making the eye
    the answer instead of the payoff. Costs the strongest claim in the first two
    seconds, so it suits YouTube more than short form.
    F numbers-forward leads with parts, cost, resolution and frame rate. Its cue 4
    ('240 by 240 pixels of eye, redrawn about 20 times a second') was impossible to
    write honestly until CG-S17 executed BENCH_PROTOCOL step 11 and measured 19-22
    FPS. No earlier draft could state it.
    G sparse is five cues with long holds, letting the orbit carry the piec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
2026-07-27 docs/media: long-form video description for the demo clip
    The 'about this video' text: opens on the contrast this audience already knows
    (most animatronic eyes wander on a timer), explains the split that makes it work
    (gaze comes from the camera, everything else is the eye's own animation), then
    turns to the reason the project exists at all.
    Uses only verified facts: ~$64 build and under $12 for extra displays from
    BOM.md, about 20 frames a second from the CG-S17 measurement, ten bundled eye
    designs, live serial tuning, and the drop-in contract that is the actual point.
    Links IRIS at its public repo rather than the private firmware one, and credits
    TeensyEyes and Chris Miller while keeping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
2026-07-27 docs/media: cut the video description to a telegraphic, paste-safe version
    Three faults in the previous one, all real:
    Hard-wrapped at ~76 columns, so pasting into YouTube arrived pre-broken.
    Paragraphs are now single unwrapped lines and there is a note saying why, since
    the next person will be tempted to tidy them.
    Too long at ~400 words. Now ~180.
    Wrong voice. Rewritten telegraphic: short clipped sentences and fragments,
    dropped subjects where speech would drop them ('Camera sits under the eye. Finds
    your face on its own.'), but still spoken rather than a spec sheet.
    Same verified facts, same public IRIS link, same TeensyEyes credit.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
2026-07-27 docs/media: tag list rebuilt around the discontinued part, plus upload settings
    The old tag list named the DFRobot part but not the Useful Sensors one people
    actually search for. Anyone typing 'person sensor' or 'SEN-21231' into YouTube
    owns a dead part or a project depending on one, so they arrive with exactly the
    problem this video solves. That group is now four of the 22 tags and is worth
    more than the broad topic terms.
    Dropped bare 'teensy' and 'dfrobot' (compete with a whole catalogue, rarely
    surface one video) and 'robot face' (pulls toward IRIS, not this build).
    22 tags, 329 characters, verified inside YouTube's 500 limit.
    Also records the upload decisions so they are not re-litiga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
